ronnykg/Iontoforese/Read.Write/Resources/Carol1.jpg

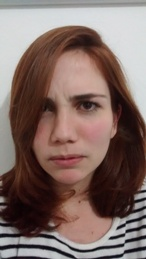
Read.Write/Resources/Carol1.jpg
