ronnykg/Iontoforese/Dados/Ana Carolina Maia Santos/Maos.png

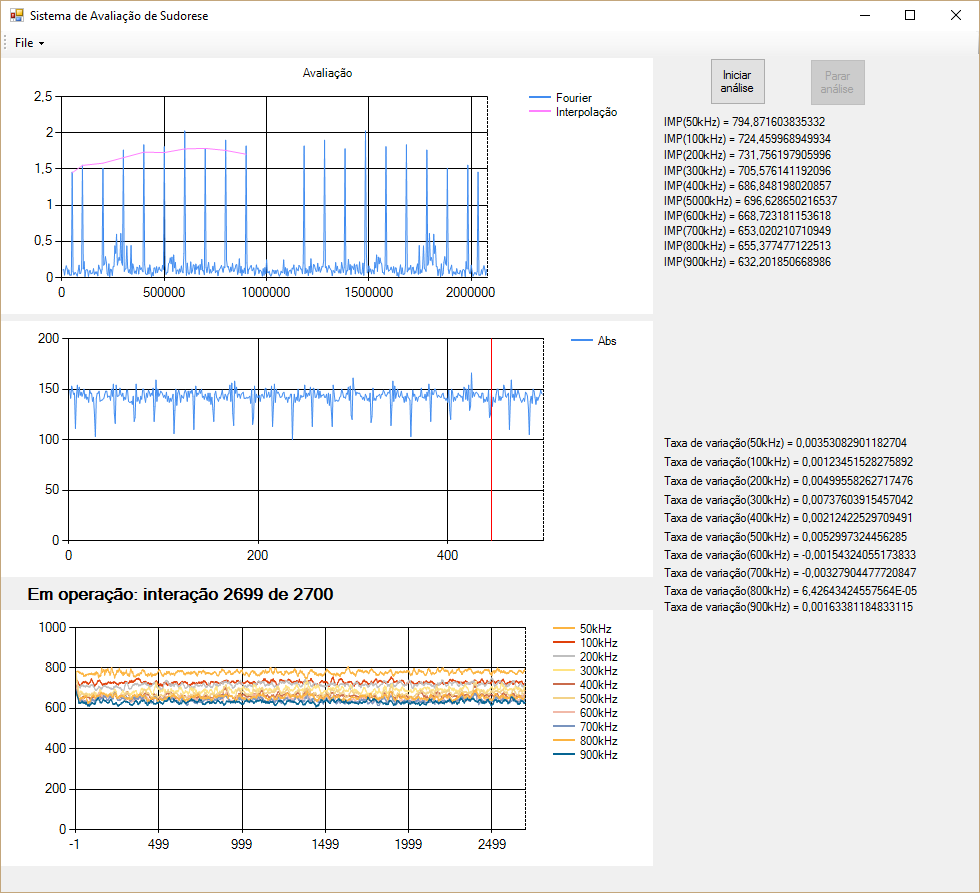
Dados/Ana Carolina Maia Santos/Maos.png
