ronnykg/Iontoforese/Dados/Ana Carolina Maia Santos/Pes.png

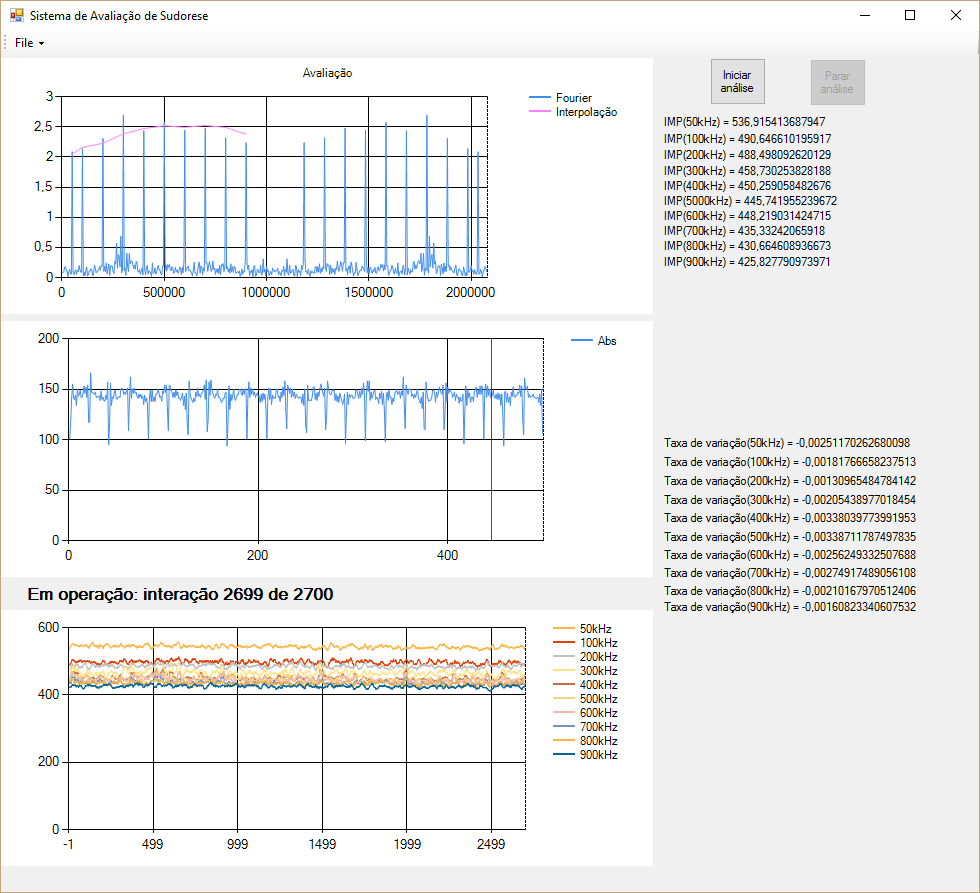
Dados/Ana Carolina Maia Santos/Pes.png
