ronnykg/Iontoforese/Dados/Bruno antonio bugardt/mao.png

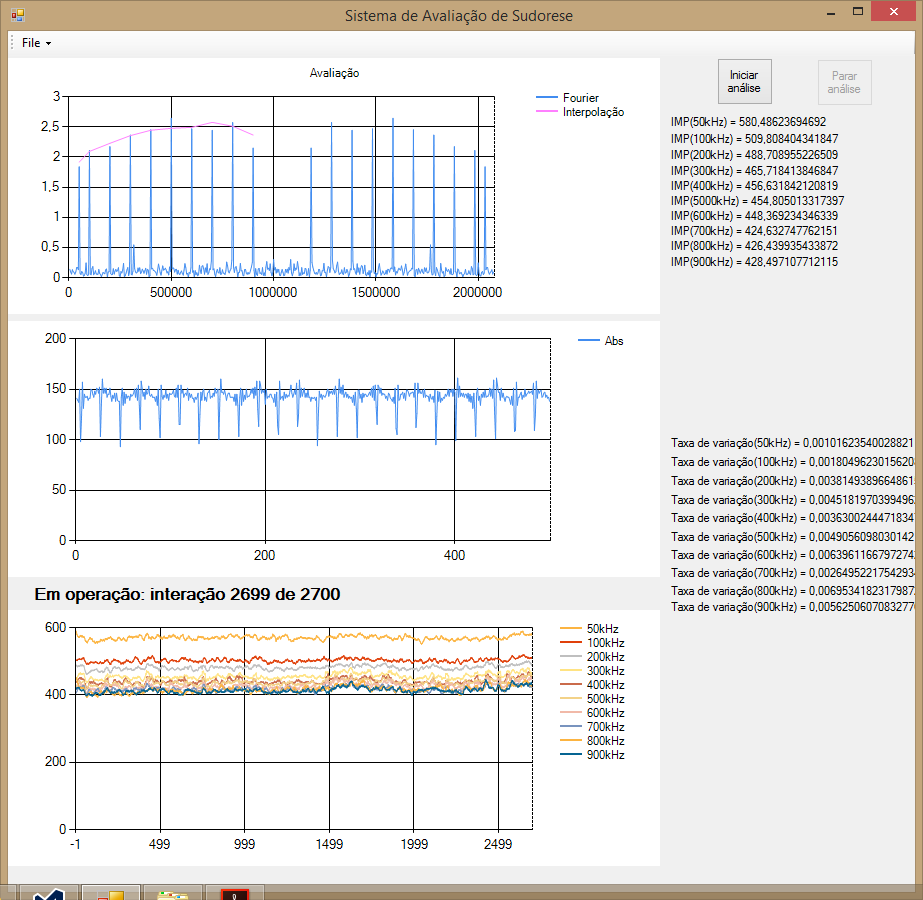
Dados/Bruno antonio bugardt/mao.png
