ronnykg/Iontoforese/Dados/Bruno Pires/maos.png

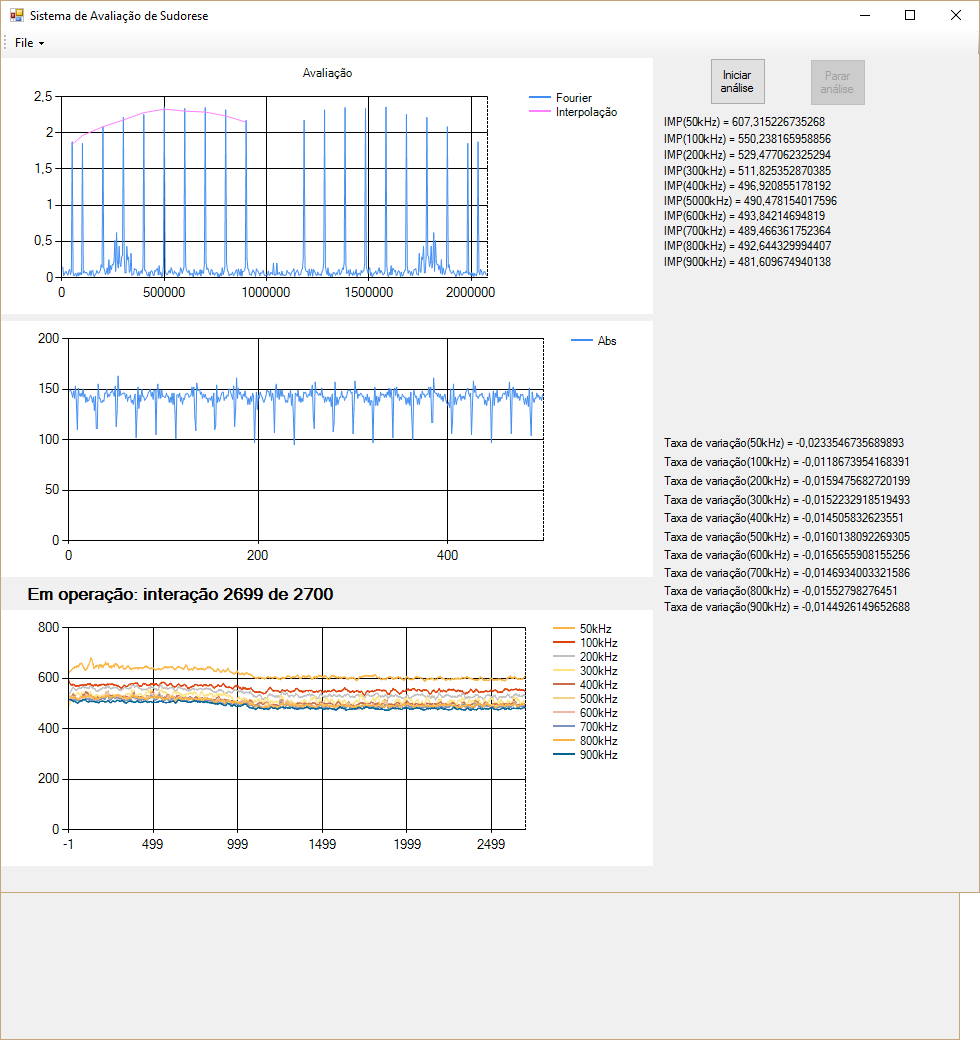
Dados/Bruno Pires/maos.png
