ronnykg/Iontoforese/Dados/Diego Coscodai/maos.png

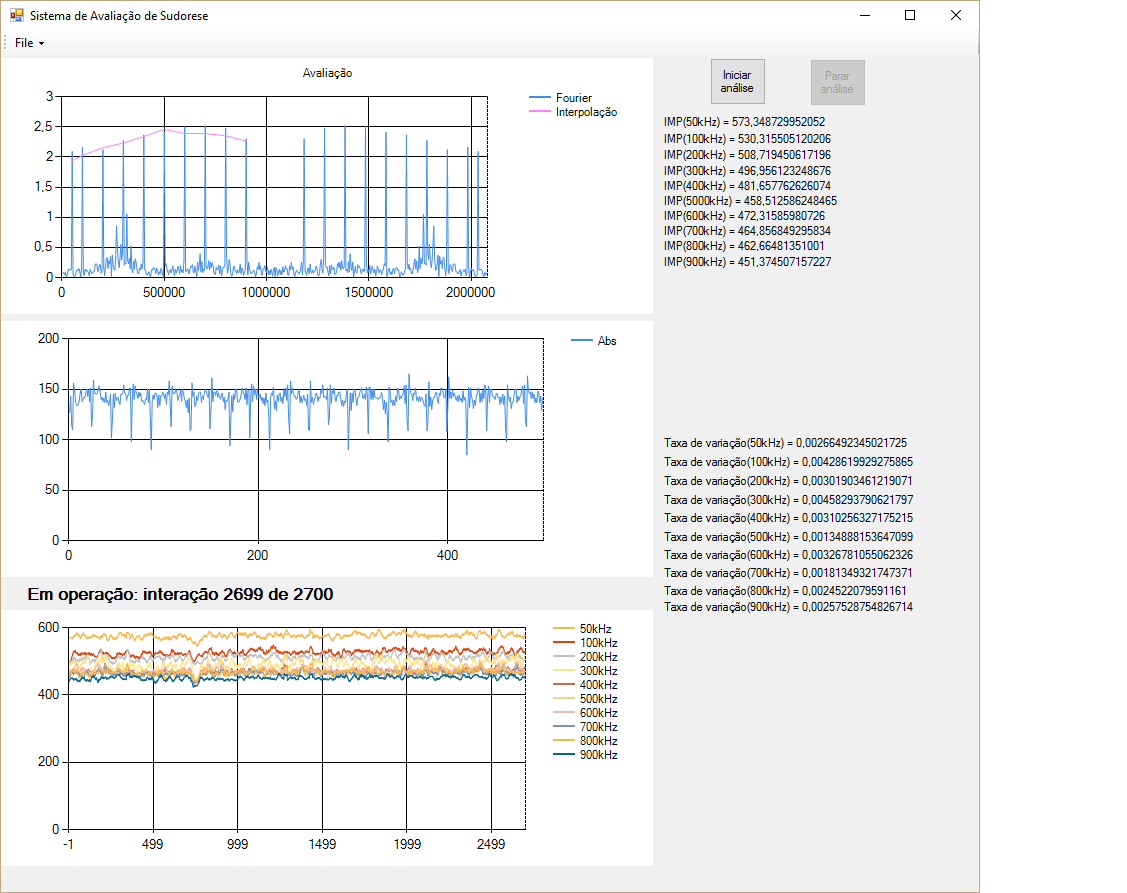
Dados/Diego Coscodai/maos.png
