ronnykg/Iontoforese/Dados/Edu Reis Neto/maos.png

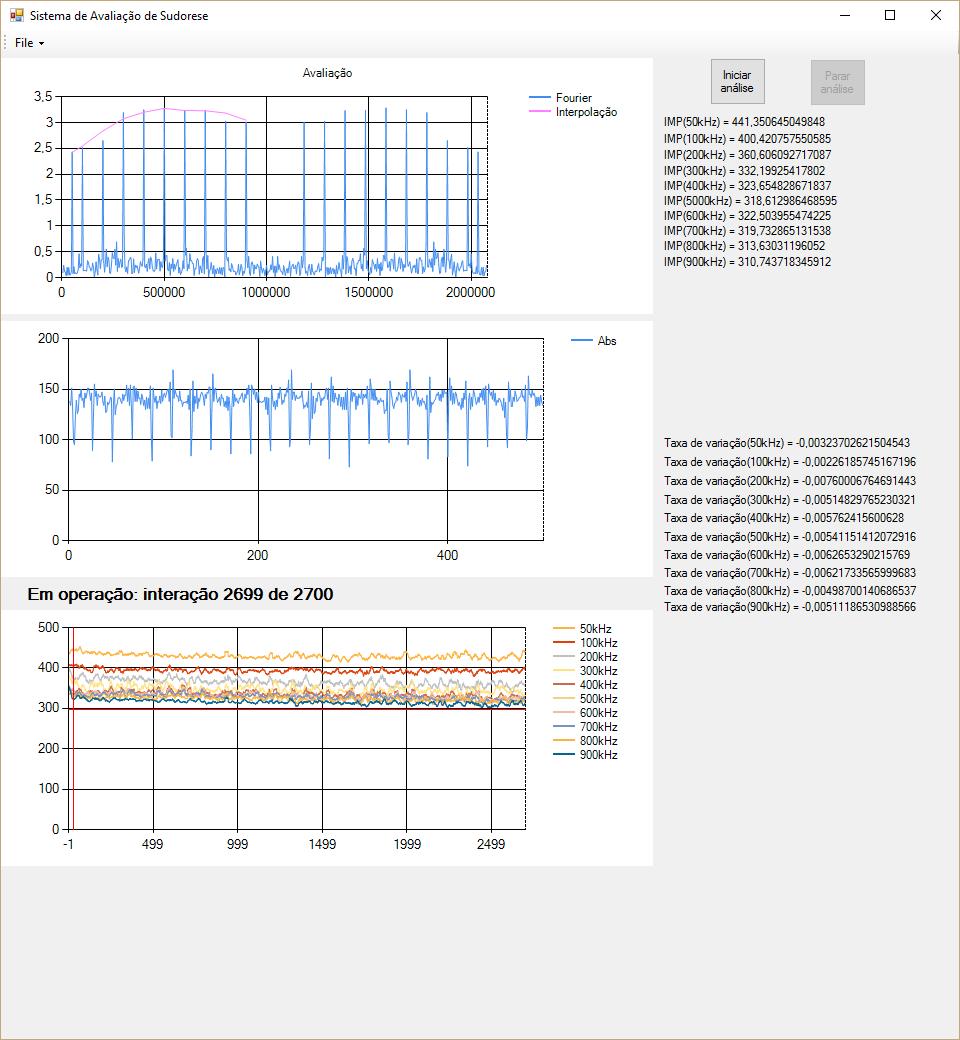
Dados/Edu Reis Neto/maos.png
