ronnykg/Iontoforese/Dados/Eronir Sislarte/Pes.png

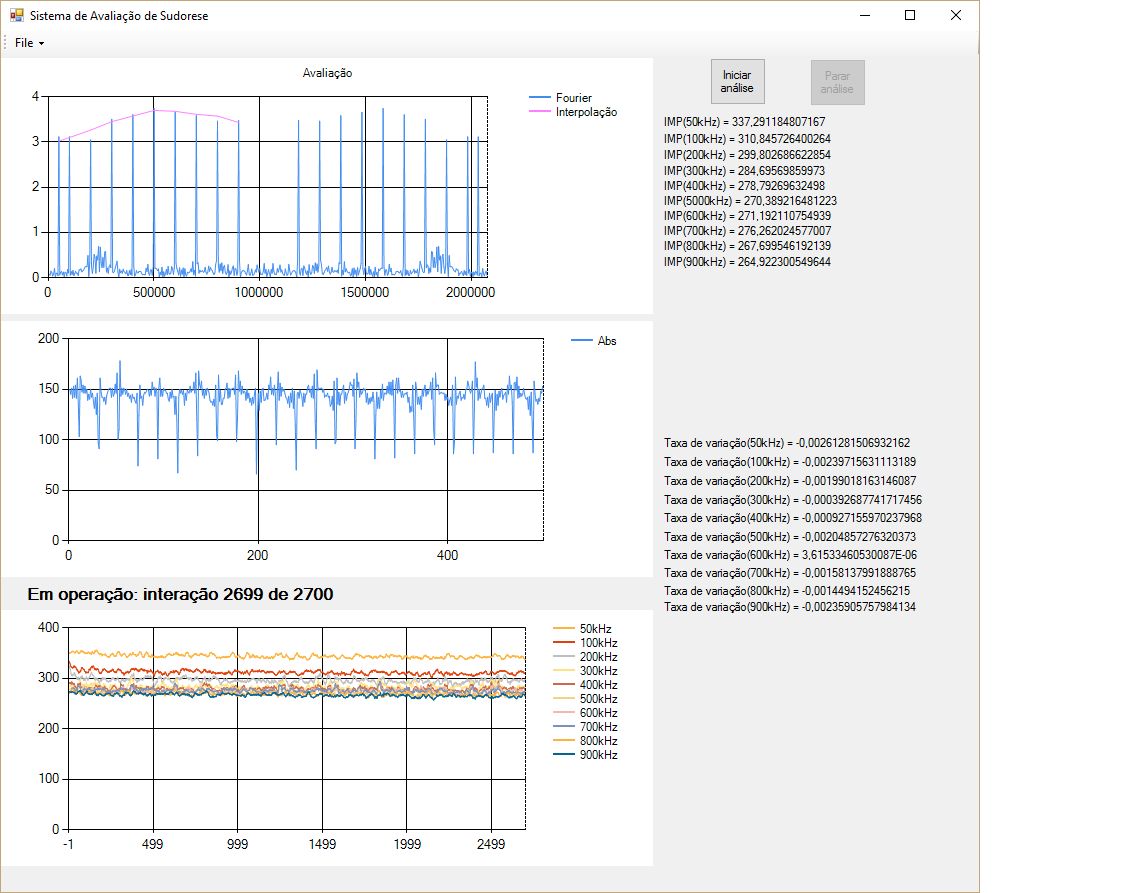
Dados/Eronir Sislarte/Pes.png
