ronnykg/Iontoforese/Dados/Ledi Isidoro/maos.png

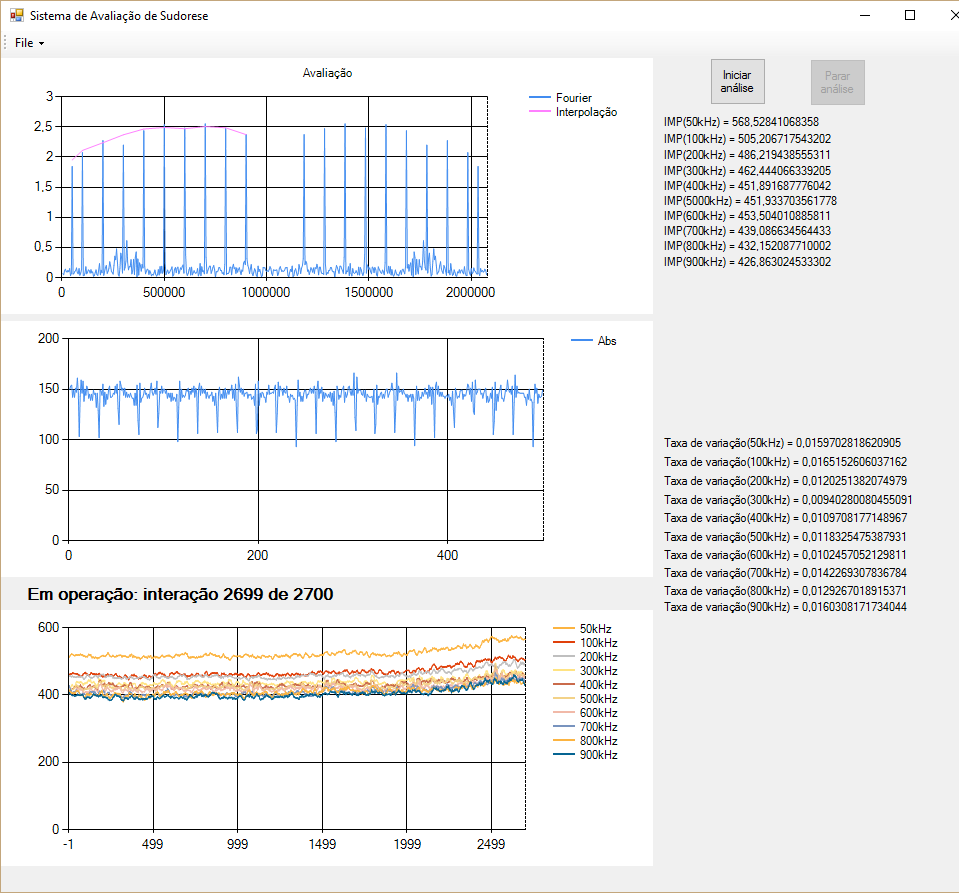
Dados/Ledi Isidoro/maos.png
