ronnykg/Iontoforese/Dados/Lorival de Oliveira/maos.png

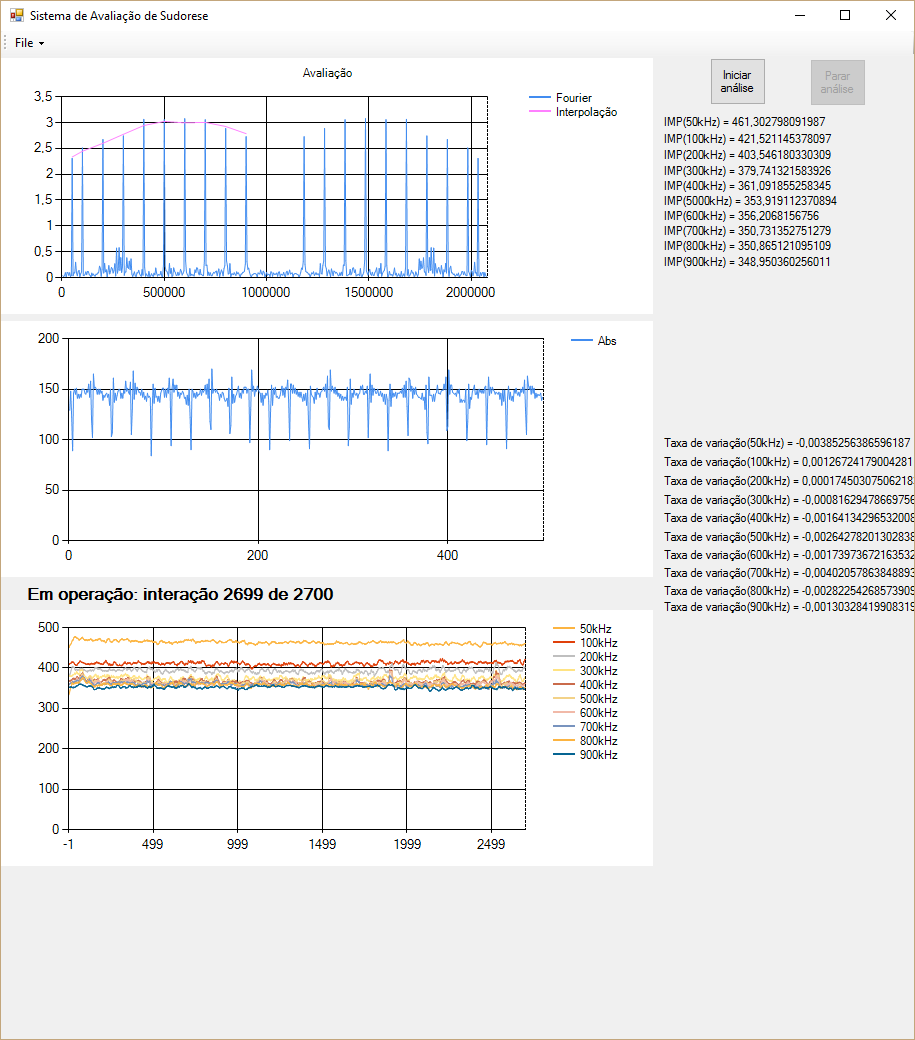
Dados/Lorival de Oliveira/maos.png
