ronnykg/Iontoforese/Dados/Lorival de Oliveira/pes.png

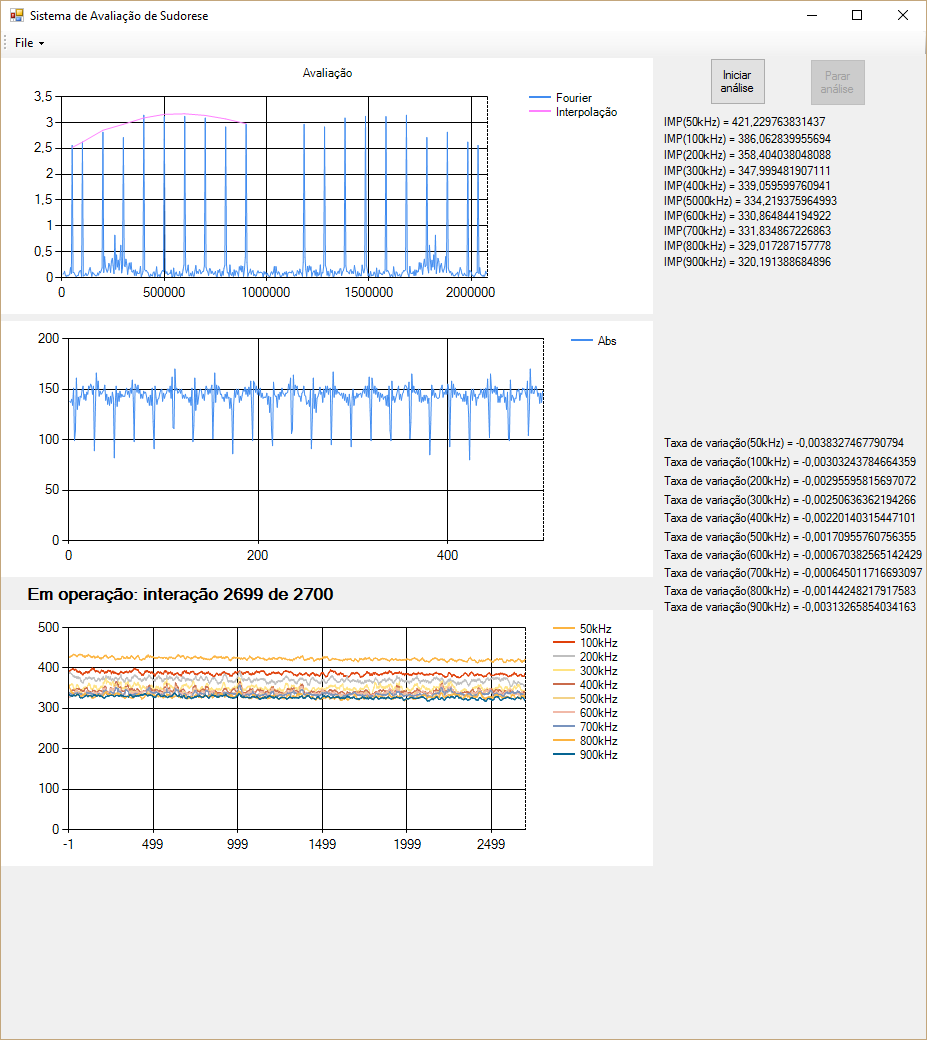
Dados/Lorival de Oliveira/pes.png
