ronnykg/Iontoforese/Dados/Lucilene Pessoa Baros/maos.png

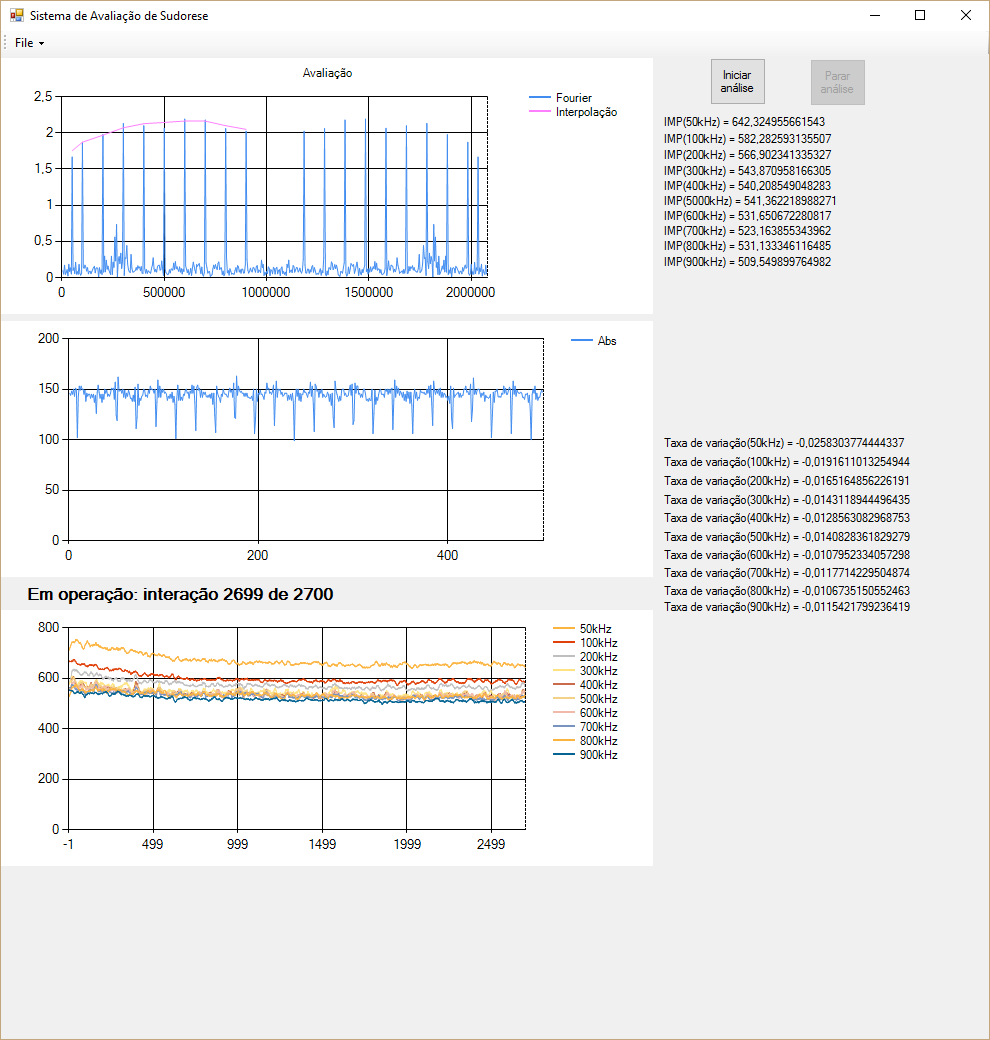
Dados/Lucilene Pessoa Baros/maos.png
