ronnykg/Iontoforese/Dados/Maria Geralda Dias/pes.png

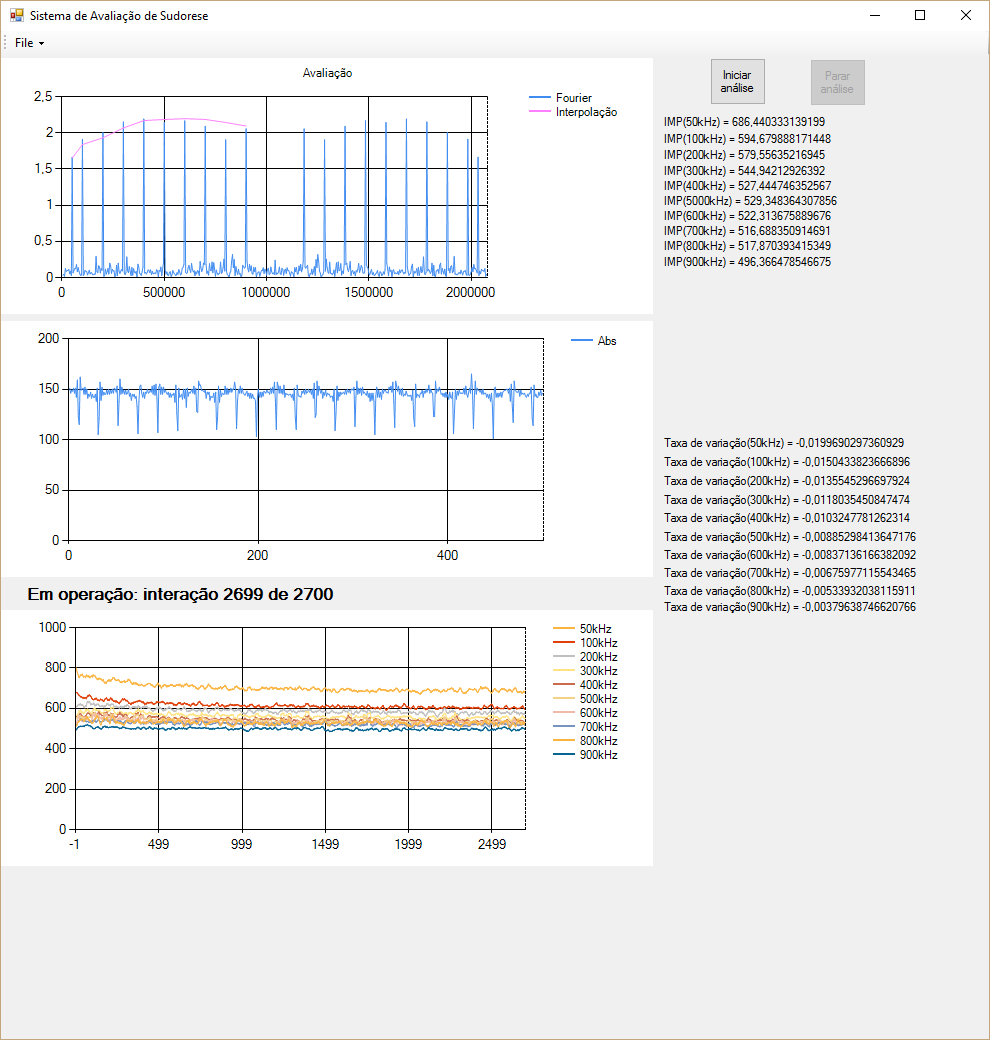
Dados/Maria Geralda Dias/pes.png
