ronnykg/Iontoforese/Dados/Miguel Soria Negreiros/pes.png

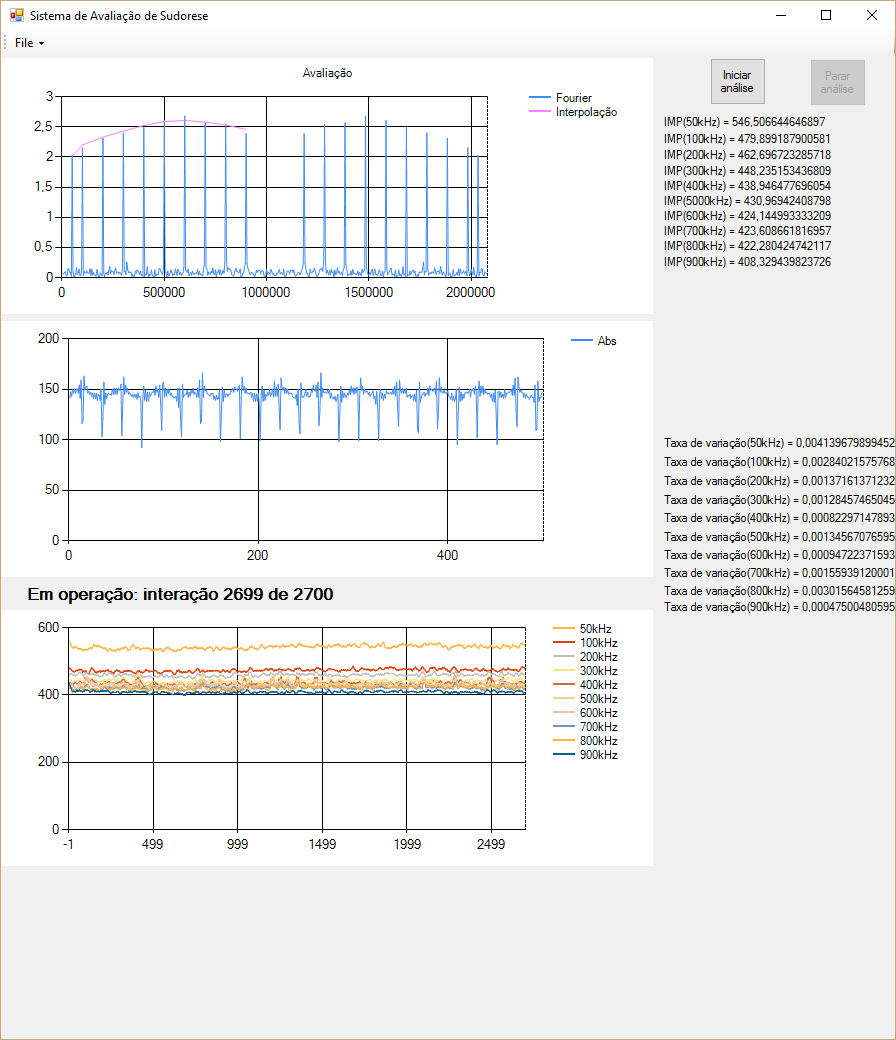
Dados/Miguel Soria Negreiros/pes.png
