ronnykg/Iontoforese/Dados/Zteste Piloto/Coscomal/mae.png

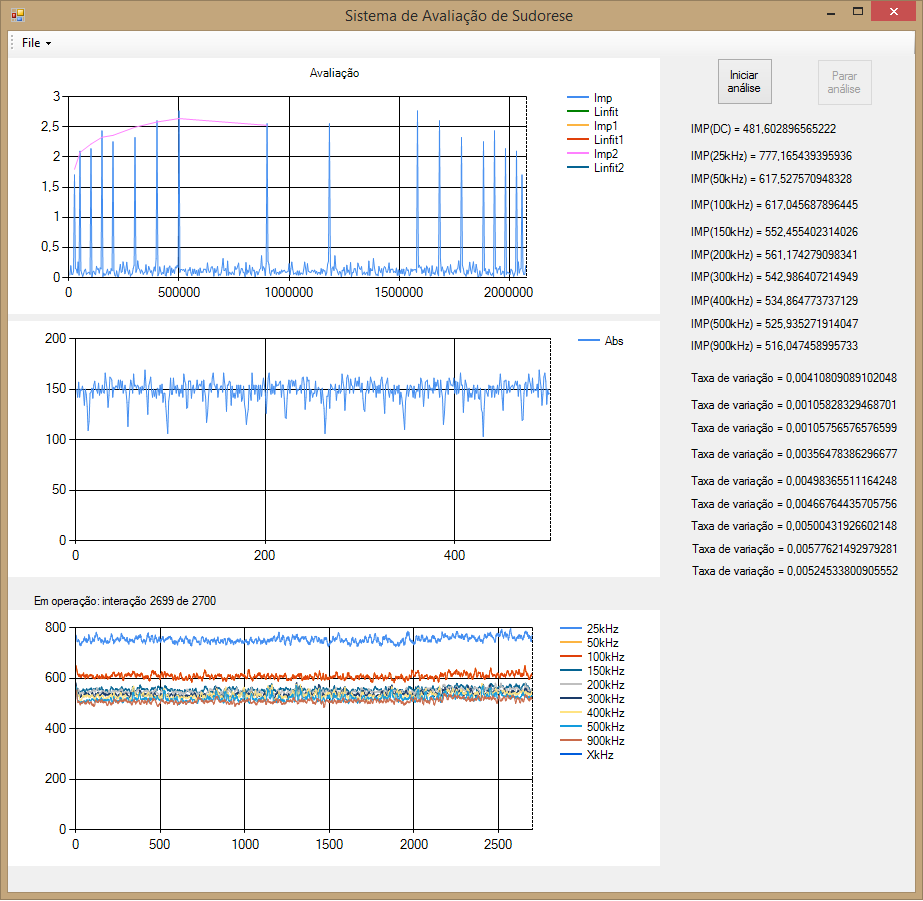
Dados/Zteste Piloto/Coscomal/mae.png
