ronnykg/Iontoforese/Read.Write/Resources/phys1_3f_3.png

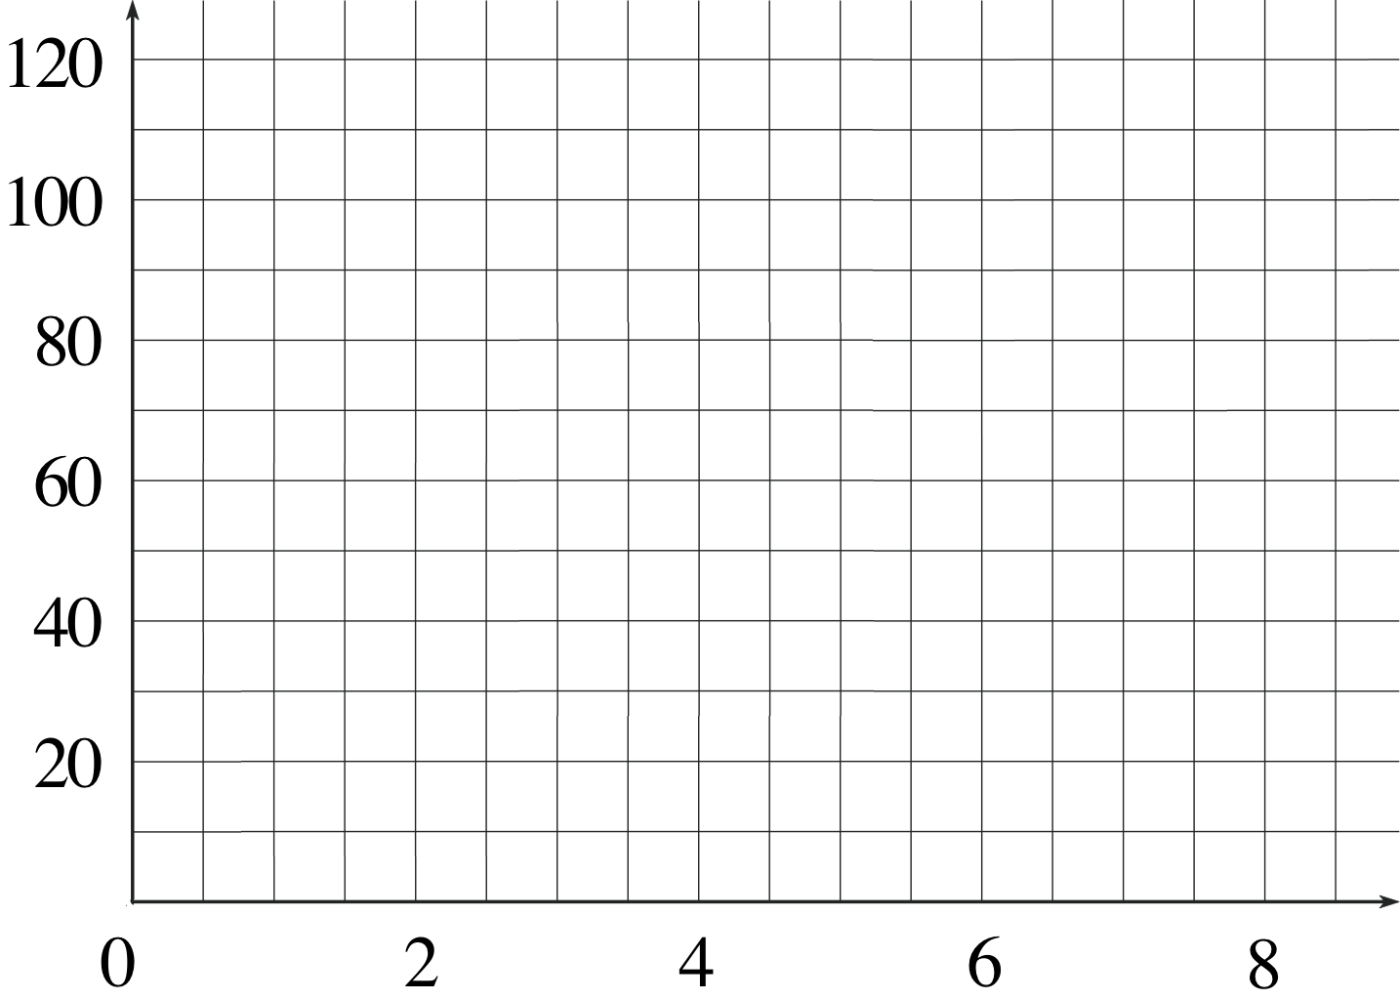
Read.Write/Resources/phys1_3f_3.png
