ronnykg/Iontoforese/NOTCH.xlsx

Sheet: Plan1
C= | 5e-07 | 0,47+0,022 | OK
R= | 5305.16477 | 3+1,2+1,1 | OK | R3 = | 2652.582385 | 1,5+1,2 | OK | Quantidade | Resistores
Q= | 2.75 |  |  | C3= | 1e-06 |  | OK | 1 | 3k
Ra= | 10000 |  | OK |  |  |  |  | 2 | 1,2k | Etapas | Fev | Mar | Abr | Mai | Jun | Jul | Ago | Set | Out | Nov | Dez | Jan | Fev | Mar
Rb= | 100000 |  | OK |  |  |  |  | 1 | 1,1k | Revisão e atualização bibliográfica sobre o contexto do projeto
 |  |  |  |  |  |  |  | 1 | 100k | Montagem de protótipo para validação do conceito
 |  |  |  |  |  |  |  | 3 | 10k | Testes Preliminares
 |  |  |  |  |  |  |  | 1 | 2.21 | Integração com FPGA
 |  |  |  |  |  |  |  | 1 | 0 (jumper) | Criação da interface IHM
 | G = 5 + 200k/RG |  |  |  |  |  |  | 1 | 1,5k | Confecção da placa de conversão de sinais
 | G = | 25 |  |  |  |  |  | Quantidade | Capacitores | Soldagem da placa
1 | Rg = | 10000 |  |  |  |  |  | 1 | 0,47u | Validação do equipamento
1 | lm358 |  |  |  |  |  |  | 1 | 0,022u | Comitê de ética
2 | ina122 |  |  |  |  |  |  | 1 | 1u | Testes com pacientes
 |  |  |  |  |  |  |  | Quantidade | Cis | Escrita da dissertação
 |  |  |  |  |  |  |  | 3 | Ina122 | Publicações
 |  |  |  |  |  |  |  | 1 | Lm358

Sheet: Plan2
 | Tensão | Resistência
Ricardo | 0.91 | 5008.928571 | G= | 25
Jeff | 0.32 | 14244.14062
Chris | 1.1 | 4143.75
Jorge | 0.3 | 15193.75
Diogo | 1.1 | 4143.75
Lucas | 0.095 | 47980.26316
Fernando | 1.28 | 3561.035156
Ronny | 0.625 | 7293
Ronny | 0.48 | 9496.09375
José | 1.22 | 3736.168033
José | 2.18 | 2090.883028
Thayse | 0.51 | 8937.5
Bruno | 0.49 | 9302.295918
Lucenara | 0.21 | 21705.35714
Lucenara | 0.23 | 19817.93478
Yukari | 0.2 | 22790.625
Diego | 0.7 | 6511.607143
Will | 0.32 | 14244.14062

Sheet: Plan3
Jan | Fev | Mar | Abr | Mai | Jun | Jul | Ago | Set | Out | Nov | Dez |  | Revisão Bibliográfica |  | Dispositivo |  | PROCESSAMENTO
 | 9 CE | 9 Reunião CÉ | 13 CE |  |  |  |  |  |  |  |  | # | Diabetes Miellitus | # | Confirmar layout | # | Teste ALTERA
 | 23 CE | 23 CE | 27 CE |  |  |  |  |  |  |  |  | # | Neuropatias multiplas |  | Característica de erro |  | Aquisição e analise
 |  |  |  |  |  |  |  |  |  |  |  | # | Neuropatias expecíficas | # | AD Converter ad9288 |  | Injeção multi-frequencial
 |  |  |  |  |  |  |  |  |  |  |  | # | Glândulas (incluindo saliva) | # | DA Converter ad5445 |  | Recepção
 |  |  |  |  |  |  |  |  |  |  |  | # | Fisiologia (Neuropatias) | # | Minimalista? | # | PC comunication?
 |  |  |  |  |  |  |  |  |  |  |  | # | Instrumentação (tipo de tratamento do sinal) |  | Auto alimentado | # | Disponibilização de dados
 |  |  |  |  |  |  |  |  |  |  |  | # | Processamento do sinal | # | Placas inox
 |  |  |  |  |  |  |  |  |  |  |  | # | Tipo de Hardware (justificativa) |  | Estrutural 3D - projeto?
 |  |  |  |  |  |  |  |  |  |  |  |  | OBJETIVO
 |  |  | Soldar AD | Testar |  |  |  |  |  |  |  |  | TER UM EQUIPAMENTO QUE POSSA MEDIR COM CONFIABILIDADE PROBLEMAS DE
 |  |  | Soldar DA | Testar |  |  |  |  |  |  |  |  | CONDUÇÂO NERVAL RELACIONADOS A NEUROPATIA PERIFÉRICA, TESTÁ-LO EM
 |  |  | Soldar resto | Testar |  |  |  |  |  |  |  |  | PESSOAS COM DIABETES, NEUROPATIA E SEM SIMTOMAS PARA COROBORAR COM
 |  |  | Injetar sinal multifrequencial |  |  |  |  |  |  |  |  |  | A QUALIDADE DO EQUIPAMENTO.
 |  |  | Receber sinal e fazer fourier
 |  |  | Melhor interface C# |  |  |  |  |  |  |  |  |  | UTILIZAR TATICAS DE PROCESSAMENTO DE SINAIS PARA EXTRAIR MAIS DADOS DOS
 |  |  | Embarcar |  |  |  |  |  |  |  |  |  | QUE OS ATUALMENTE ENCONTRADOS NA LITERATURA.
 |  |  | Apresentação

Sheet: Lista de materiais
 |  |  | 2k | 3.74k | 4.99k |  | 12.7k | 20k | 24k | 30k |  |  |  | 2.2
 | 1.5k | 3.3k | 4.7k | 5.6k | 6.8k | 10k |  | 12k | 22k | 27k | PoT 100k | 4.7uf | 100nf | 1pf | 10pf | LT6323 | AD9288 | AD5445 | Barra pino(20x2) | Born alimentação | Jumper | Barra pino (3x1)
Ponte de Wheatstone |  |  |  |  |  | 9
Filtro 3Mhz | 2 | 2 |  |  |  |  |  |  |  |  | 1 | 4 | 4 |  | 4 | 1
Controle automático de ganho |  |  | 3 | 3 | 3 | 3 | 3 | 3 | 3 | 21 |  |  |  |  |  | 3
ADC |  |  |  |  |  |  |  |  |  |  |  |  |  |  |  |  | 2
DAC |  |  |  |  |  |  |  |  |  |  |  |  |  | 1 |  |  |  | 1
Avulsos |  |  |  |  |  |  |  |  |  |  |  |  |  |  |  |  |  |  | 2 | 6 | 3 | 3
 | 4 | 6 | 6 | 9 | 7 | 25 | 6 | 6 | 6 | 45 |  | 8 | 8 | 2 | 8
 |  |  |  |  |  |  |  |  |  |  |  |  |  |  |  |  |  |  |  |  | x'
 | 1.5k | 1.2k | 2k | 3.3k | 4.7k | 5.6k | 10k | 12k | 15k | 30k
Controle automático de ganho | 10 | 10 | 10 | 10 | 10 | 10 | 25 | 10 | 10 | 10 |  | 3 | 10 |  | 10 | 4 | 2 | 1
SOLDAR PLACA ALIMENTAÇÂO | AMPOPS |  |  | POT? |  | BORNs? |  |  | BATERIA 9V?
SOLDAR DAC - TESTAR
SOLDAR FILTRO, GANHO - TESTAR | TROCAR COMPONENTES COM PLACA ANT.
SOLDAR CONT de GANHO - TESTAR | GANHOS VARIADOS. |  |  |  |  | R = 1,2k 5,6k 15k
SOLDAR ADC - TESTAR

Sheet: Pacientes
NOME | Sexo | Idade | Peso | Altura | IMC | Diabetes | Duração diabetes (anos) | Neuropatia aut. | HbA1C (%) | Observações(retinopatia, nefropatia..) | Contato | 1a | 1b | 2a | 2b | 3a | 3b | 4a | 4b | 5a | 5b | 6a | 6b
Ricardo | M | 26 | 75 | 1.8 | 23.14814815 | n | n | n | n | n
Andreza Souza | F | 40 | 77 | 1.64 | 28.62879239 | 1 | 27 | n | 8.4 | Sintrome turne carter, nervo do pulso LER
Bruno antonio bugardt | M | 23 | 63 | 1.7 | 21.79930796 | n | n | n | n | n
Deise Luciano | F | 43 | 94 | 1.7 | 32.52595156 | 2 | 20 | n | 8.9 | n
Bruno Lima | M | 25 | 80 | 1.8 | 24.69135802 | n | n | n | n | n
Guilherme Nascimento | m | 18 | 60 | 1.7 | 20.76124567 | 1 | 15 | n | 8.5 | n
Denise Cristina Costa Custodio | F | 29 | 78 | 1.45 | 37.09869203 | 2 | 6 | n | 7 | n
Diego Coscodai | M | 28 | 77 | 1.78 | 24.30248706 | 1 | 10 | n | 6.5 | n |  | 0 | 0 | 0 | 0 | 0 | 0 | 0 | 0 | 0 | 0 | 0 | 0
Vanessa Steffens | F | 21 | 65 | 1.55 | 27.05515088 | 1 | 19 | possível | 10.3 | edema nos Membros inferiores, dores, caimbras e glicemia alta
Rosimere Laus | F | 50 | 60 | 1.53 | 25.6311675 | 1 | 8 | possível | 10.4 | Calos, caibrã.
Jessica Thamara Fernandes | F | 24 | 60 | 1.58 | 24.03460984 | 1 | 12 | n | 6.6 | Gravida
Nilse | F | 46 | 54 | 1.57 | 21.90758246 | 1 | 34 | S | 7.8 | Retinopatia, amputação de dedo mínimo | 32425000 | 0 | 0 | 0 | 0 | 0 | 0 | 3 | 3 | 0 | 0 | 3 | 3
Anderson da Rosa | M | 36 | 70 | 1.68 | 24.8015873 | 1 | 33 | S | 7.1 | Refluxo, problema nos rins, retinopatia. Sem indícios de neuro periférica.Cloridrano de betaina (controle de pH esfago) | 91820330/36655125 | 0 | 0 | 0 | 0 | 1 | 1 | 2 | 2 | 0 | 0 | 0 | 0
Mateus Fafretto | M | 24 | 83 | 1.78 | 26.19618735 | n | n | n | n | n | 5491313862 | 0 | 0 | 0 | 0 | 0 | 0 | 0 | 0 | 0 | 0 | 0 | 0
Joao Antonio Marcola | M | 24 | 86 | 1.78 | 27.1430375 | n | n | n | n | n |  | 0 | 0 | 0 | 0 | 0 | 0 | 0 | 0 | 0 | 0 | 0 | 0
Jose Berkenbrock | M | 27 | 90 | 1.83 | 26.8744961 | n | n | n | n | n | 96039991 | 0 | 0 | 0 | 0 | 0 | 0 | 0 | 0 | 1 | 1 | 0 | 0
Miguel Soria Negreiros | M | 32 | 74 | 1.7 | 25.60553633 | n | n | n | n | n | 92 991467294 | 0 | 0 | 0 | 0 | 0 | 0 | 0 | 0 | 0 | 0 | 0 | 0
Edu Reis Neto | M | 22 | 92 | 1.9 | 25.48476454 | 1 | 19 | n | 9 | n | 96686037 | 0 | 0 | 0 | 0 | 0 | 0 | 0 | 0 | 0 | 0 | 0 | 0
Maria Geralda Dias | F | 47 | 69 | 1.58 | 27.63980131 | 2 | 8 | n | 8 | n | 96034202 | 0 | 0 | 0 | 0 | 2 | 1 | 0 | 0 | 0 | 0 | 0 | 0
Lucilene Pessoa Baros | F | 49 | 64 | 1.53 | 27.339912 | 1 | 10 | S | 12 | Homeprazol/ Refluxo | 84784471 | 1 | 1 | 3 | 3 | 1 | 1 | 3 | 3 | 0 | 0 | 3 | 3
Jean Pereira da Rocha | M | 24 | 56 | 1.75 | 18.28571429 | n | n | n | n | n | 91796340 | 0 | 0 | 0 | 0 | 0 | 0 | 0 | 0 | 0 | 0 | 0 | 0
Lorival De Oliveira | M | 38 | 71 | 1.73 | 23.72281065 | 1 | 17 | n | 6.9 | n | 98149702 | 1 | 1 | 0 | 0 | 1 | 1 | 0 | 0 | 0 | 0 | 1 | 2
Mauricio Ademir Teodoro | M | 34 | 95 | 1.89 | 26.59500014 | 1 | 26 | n | 7.2 | Dor nas pernas por canceira no fim do dia | 84705568 | 0 | 0 | 0 | 0 | 0 | 0 | 0 | 0 | ? | 1 | 0 | 0
Sonir Schafer | M | 49 | 84 | 1.72 | 28.39372634 | 1 | 1.5 | n | 7.64 | Cansaço, Ligação do reto | 84646548 | 0 | 0 | 0 | 0 | 0 | 0 | 0 | 0 | 0 | 0 | 0 | 0
Jorge Loureiro | M | 51 | 77 | 1.81 | 23.50355606 | n | n | n | n | n | 98148778 | 0 | 0 | 0 | 0 | 0 | 0 | 0 | 0 | 0 | 0 | 0 | 0
Bruno Pires | M | 25 | 84 | 1.89 | 23.51557907 | n | n | n | n | n | 91691319 | 0 | 0 | 0 | 0 | 0 | 0 | 0 | 0 | 0 | 0 | 1 | 0
Ledi Isidoro | F | 54 | 100.5 | 1.54 | 42.37645471 | 2 | 4 | possível | n | Perda de suavidade nos pés mesmo com uso de cremes | 99421688 | 0 | 0 | 0 | 0 | 0 | 0 | 0 | 0 | 0 | 0 | 3 | 3
Maikon Simas | M | 36 | 107 | 1.63 | 40.27249802 | 2 | 9 | n | 7 | Pseuriase tratada, deficiencia vit. D | 84523792 | 1 | 1 | 0 | 0 | 0 | 0 | 0 | 0 | 0 | 0 | 0 | 0
Maria Luiza Vida Lens | F | 45 | 72 | 1.45 | 34.24494649 | 2 | 3 | n | 7 | Artrose, derrame no braço direito, reumatismo cranico | 96698653 | 0 | 0 | 3 | 2 | 0 | 0 | 1 | 1 | 1 | 3 | 1 | 2
Eronir Sislarte | M | 55 | 102 | 1.82 | 30.79338244 | 1 | 1 | n | 8 | Transplante de figado | 96172124 | 0 | 0 | 0 | 0 | 0 | 0 | 0 | 0 | 0 | 0 | 0 | 0
Joao Batista Campos Vieira | M | 41 | 67 | 1.76 | 21.62964876 | 1 | 31 | Periférica | 11.5 | Fisgadas no pé, sensação de corpo estranho no pé, neuropatia pé direito. Sensações sempre relacionadas a esforço fisico. | 84436429 | 1 | 3 | 0 | 0 | 1 | 3 | 0 | 0 | 1 | 3 | 3 | 0
Reginaldo Joaquim da Silva | M | 36 | 110 | 1.69 | 38.51405763 | 1 | 19 | n | 7.2 | Def. de vitamina D. Insuficiencia Renal (45%) . Inchaço no periodo noturno nos pés causado por problemas renais. | 32654584/99594475 | 0 | 0 | 0 | 0 | 0 | 0 | 0 | 0 | 0 | 0 | 0 | 0
Sandro Vieira de Souza | M | 47 | 71 | 1.72 | 23.99945917 | 1 | 36 | n | 6.4 | Sente dor no nervo unar, tendões, ombros. Dormencia gerada pela dor no nervo | 49 32784454/49 99632608 | 0 | 0 | 0 | 0 | 0 | 0 | 1 | 0 | 0 | 0 | 0 | 0
Ivania Vieira de Souza | F | 47 | 79 | 1.64 | 29.37239738 | 1 | 24 | Periférica | 9 | Def. vit D. Toma Neurapentina e Duoxetina (para dor da neuropatia). 10 anos de neuropatia. Calor em excesso no verão nos pés. Dormencia em regiões dos pes, doi ao calçar. Dor na região dos gluteos. Pés inchados | 33550559 99014368 | 1 | 2 | 1 | 1 | 1 | 0 | 3 | 0 | 1 | 1 | 1 | 2
Lucas Herzer | M | 24 | 65 | 1.71 | 22.22906193 | n | n | n | n | n |  | 0 | 0 | 0 | 0 | 0 | 0 | 0 | 0 | 0 | 0 | 0 | 0
Sariane Ribeiro Silva | F | 21 | 58 | 1.6 | 22.65625 | n | n | n | n | Possível Anemia |  | 0 | 0 | 0 | 0 | 1 | 1 | 1 | 1 | 0 | 0 | 0 | 0
Jefson De Souza Junior | M | 26 | 90 | 1.71 | 30.77870114 | n | n | n | n |  |  | 0 | 0 | 0 | 0 | 0 | 0 | 0 | 0 | 0 | 0 | 0 | 0
Anna Carolina Russi | F | 25 | 49 | 1.6 | 19.140625 | n | n | n | n | n |  | 0 | 0 | 0 | 0 | 0 | 0 | 0 | 0 | 0 | 0 | 0 | 0
Thiago Albuquerque Baratto | M | 26 | 70 | 1.7 | 24.22145329 | n | n | n | n | Alcolismo, alergia a algo (prov. Cachorro). |  | 0 | 0 | 0 | 0 | 0 | 0 | 0 | 0 | 0 | 0 | 1 | 1
Ana Carolina Maia Santos | F | 24 | 63 | 1.73 | 21.0498179 | n | n | n | n | Anemia |  | 0 | 0 | 0 | 0 | 1 | 2 | 1 | 1 | 0 | 0 | 1 | 1
Vagner Rodrigues | M | 26 | 65.8 | 1.65 | 24.16896235 | n | n | n | n | n |  | 0 | 0 | 0 | 0 | 0 | 0 | 0 | 0 | 0 | 0 | 0 | 0
 |  |  |  |  | #DIV/0!
 |  |  |  |  | #DIV/0!
 |  |  |  |  | #DIV/0!
 |  |  |  |  | #DIV/0!
 |  |  |  |  | #DIV/0!
 |  |  |  |  | #DIV/0!
 |  |  |  |  | #DIV/0!
 |  |  |  |  | #DIV/0!
 |  |  |  |  | #DIV/0!
 |  |  |  |  | #DIV/0!
 |  |  |  |  | #DIV/0!
 |  |  |  |  | #DIV/0!
 |  |  |  |  | #DIV/0!
 |  |  |  |  | #DIV/0!
 |  |  |  |  | #DIV/0!
 |  |  |  |  | #DIV/0!
 |  |  |  |  | #DIV/0!

Sheet: Descartados
Julia Wolff | F | 35 | 59 | 1.61 | 22.76146754 | n | n | n | n | Possível Deficiencia de vit. D | 4784912282 | 0 | 0 | 0 | 0 | 0 | 0 | 0 | 0 | 0 | 0 | 3 | 1
Cristina Schreiber | F |  |  |  | #DIV/0! | n | n | n | n | 8 pinos de titânio na perna
