ronnykg/Iontoforese/(list of files, cad)

Other CAD files:
VHDL/simulation/modelsim/ieee_proposed/fixed_float_types/_vhdl.psm
VHDL/simulation/modelsim/ieee_proposed/fixed_pkg/_vhdl.psm
VHDL/simulation/modelsim/ieee_proposed/fixed_pkg/body.psm
VHDL/simulation/modelsim/ieee_proposed/float_pkg/_vhdl.psm
VHDL/simulation/modelsim/ieee_proposed/float_pkg/body.psm
VHDL/simulation/modelsim/rtl_work/de2_clock/a.psm
VHDL/simulation/modelsim/rtl_work/devreq/handler.psm
VHDL/simulation/modelsim/rtl_work/devreq_inc/_vhdl.psm
VHDL/simulation/modelsim/rtl_work/drv/handler.psm
VHDL/simulation/modelsim/rtl_work/hal/handler.psm
VHDL/simulation/modelsim/rtl_work/isp_drv/_vhdl.psm
VHDL/simulation/modelsim/rtl_work/isp_hal/_vhdl.psm
VHDL/simulation/modelsim/rtl_work/isp_inc/_vhdl.psm
VHDL/simulation/modelsim/rtl_work/my_library/a.psm
VHDL/simulation/modelsim/rtl_work/types/_vhdl.psm
VHDL/simulation/modelsim/rtl_work/usb_inc/_vhdl.psm
VHDL/simulation/modelsim/rtl_work/usb_inc/body.psm
