ronnykg/Iontoforese/Dados/Zteste Piloto/guilherme/Resultado.txt

884,831226188367 750,685134251003 750,108544539587 632,343335956917 658,969294934877 632,224453397394 599,501538025164 583,694009222684 579,266520409503
892,104361916262 746,166161080883 745,592785432888 635,372041945918 659,020221451846 630,906515384897 601,920500891162 586,777852193873 582,366831613526
895,69713361933 745,643232434705 745,070228713201 634,111541589404 660,639591999668 635,291245088389 608,96287933238 593,784488098289 588,04753133418
888,475879167609 744,068555359187 743,496671607153 634,140025248989 657,366812482962 632,817264768916 613,347200428857 598,154741577932 585,899515986473
881,47015246444 736,073744562409 735,507547020046 631,876009333263 649,153986147338 625,745525055097 609,734484447237 596,010940045821 581,407902584925
866,805808796968 726,580056486925 726,020611212041 629,971963333846 640,412614106909 616,682078382403 605,943499438058 591,999188961529 576,357738861392
852,202977637368 719,072052696241 718,517947395604 627,35279469643 631,825508991398 611,438858513416 600,540633559621 588,954010499008 570,700882018434
838,250514041457 706,661384290642 706,116105923437 622,895494761387 626,651815417924 607,761575915703 596,690967103321 582,3684148923 567,407212055633
824,938020810369 693,370055455967 692,834230380963 616,646357731271 620,192579808948 600,807549457102 591,600724126741 579,764723465699 565,095794860273
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
782,288057903264 650,522666630622 650,017316227613 583,647285413671 579,596908473812 562,92649976838 557,844449740203 548,843821500069 536,085612983959
778,723130490979 653,527055495137 653,019568257943 583,898997073108 581,862867276153 563,764648284666 558,640797659835 546,076629793086 540,458401753107
775,110164298752 654,981382925295 654,472861315817 584,633165074984 581,036701277611 564,765489533526 557,510377421601 546,803311941887 538,400802219537
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
