ronnykg/Iontoforese/adc.brd

## EAGLE design adc.brd (2016-02-25)

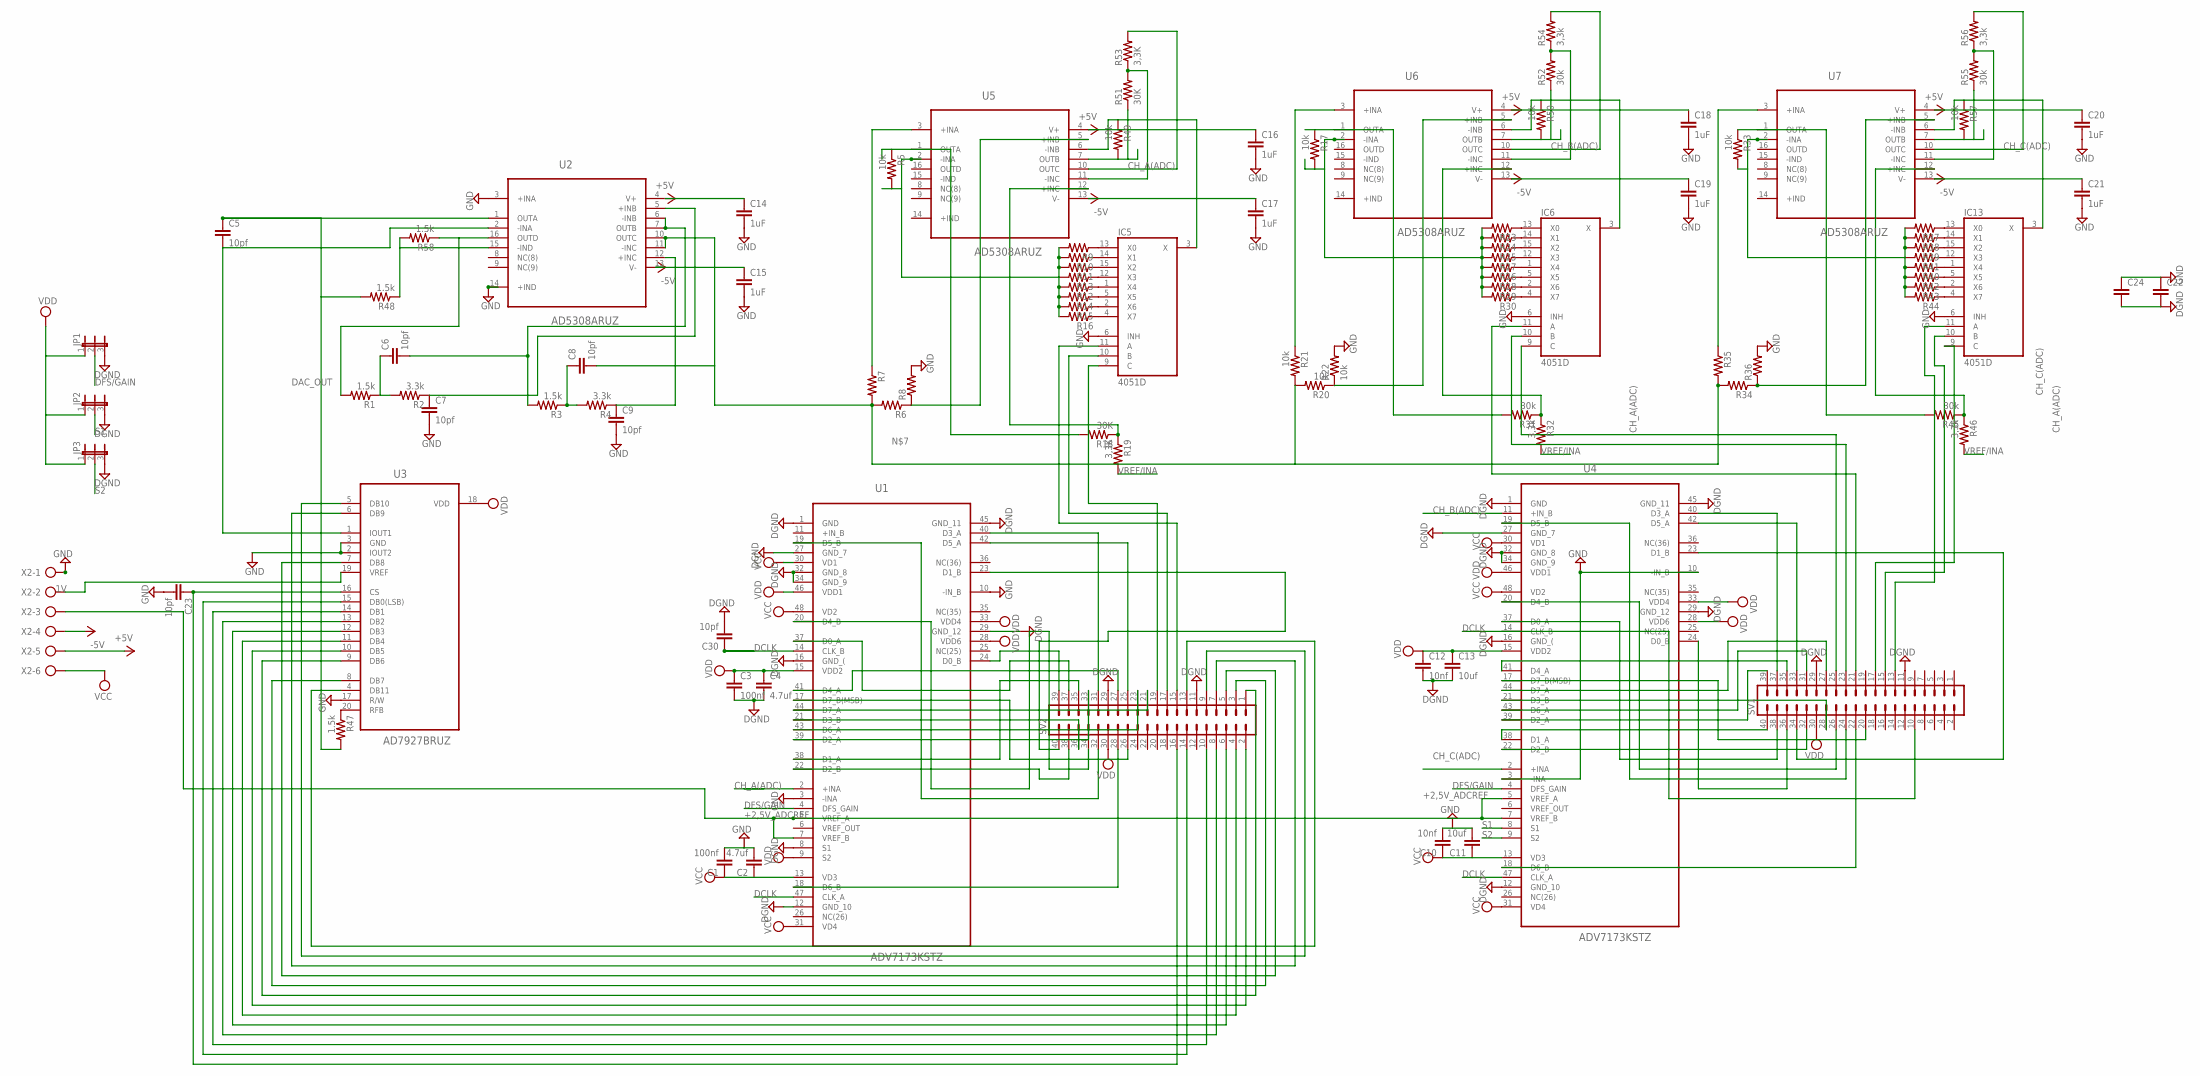
[picture p37: schematic adc.sch]

Parts:
C1, C3: 100nf; C0603
C2, C4: 4.7uf; C0603
C5, C6, C7, C8, C9, C23, C30: 10pf; C0603
C10, C12: 10nf; C0603
C11, C13: 10uf; C0603
C14, C15, C16, C17, C18, C19, C20, C21: 1uF; C0603
C22: C2,5-3; C2.5-3
C24: C10/6; C10B6
IC5, IC6, IC13: 4051D; SO16
JP1, JP2, JP3: JP2E; JP2
R1, R3, R47, R48, R58: 1.5k; 0603
R2, R4: 3.3k; 0603
R5, R17, R20, R21, R22, R33, R49, R50, R57: 10k; 0603
R6, R7, R8, R9, R10, R11, R12, R13, R14, R15, R16, R23, R24, R25, R26, R27, R28, R29, R30, R34, R35, R36, R37, R38, R39, R40, R41, R42, R43, R44: RESISTOR0603; 0603
R18, R51: 30K; 0603
R19, R53: 3,3K; 0603
R31, R45, R52, R55: 30k; 0603
R32, R46, R54, R56: 3,3k; 0603
SV1, SV2: MA20-2
U1, U4: ADV7173KSTZ; QFP50P900X900X160-48N
U2, U5, U6, U7: AD5308ARUZ; SOP65P640X120-16N
U3: AD7927BRUZ; SOP65P640X120-20N
X2: AK300/6

Connections:
1V: U3.19 (VREF), X2.2
+2,5V_ADCREF: U1.5 (VREF_A), U1.7 (VREF_B), U4.5 (VREF_A), U4.7 (VREF_B), X2.3
+5V: C14.1, C16.1, C18.1, C20.1, IC5.16 (+5V), IC6.16 (+5V), IC13.16 (+5V), U2.4 (V+), U5.4 (V+), U6.4 (V+), U7.4 (V+), X2.5
+IN_B: U1.11 (+IN_B)
-5V: C15.1, C17.1, C19.1, C21.1, IC5.7 (VEE), IC6.7 (VEE), IC13.7 (VEE), U2.13 (V-), U5.13 (V-), U6.13 (V-), U7.13 (V-), X2.4
CH_A(ADC): R53.2, U1.2 (+INA), U5.10 (OUTC)
CH_B(ADC): R54.2, U4.11 (+IN_B), U6.10 (OUTC)
CH_C(ADC): R56.2, U4.2 (+INA), U7.10 (OUTC)
DAC_OUT: C5.1, R47.2, R48.2, U2.1 (OUTA)
DCLK: C30.1, SV1.10, U1.14 (CLK_B), U1.47 (CLK_A), U4.14 (CLK_B), U4.47 (CLK_A)
DFS/GAIN: JP1.2, U1.4 (DFS_GAIN), U4.4 (DFS_GAIN)
DGND: C3.2, C4.2, C12.2, C13.2, C22.2, C24.2, C30.2, JP1.3, JP2.3, JP3.3, SV1.11, SV1.29, SV2.11, SV2.29, U1.1 (GND), U1.8 (S1), U1.12 (GND_10), U1.16 (GND_(), U1.27 (GND_7), U1.29 (GND_12), U1.32 (GND_8), U1.34 (GND_9), U1.45 (GND_11), U4.1 (GND), U4.12 (GND_10), U4.16 (GND_(), U4.27 (GND_7), U4.29 (GND_12), U4.32 (GND_8), U4.34 (GND_9), U4.45 (GND_11)
GND: C1.2, C2.2, C7.2, C9.2, C10.2, C11.2, C14.2, C15.2, C16.2, C17.2, C18.2, C19.2, C20.2, C21.2, C22.1, C23.2, C24.1, IC5.6 (INH), IC5.8 (GND), IC6.6 (INH), IC6.8 (GND), IC13.6 (INH), IC13.8 (GND), R8.2, R22.2, R36.2, U1.3 (-INA), U1.10 (-IN_B), U2.3 (+INA), U2.14 (+IND), U3.2 (IOUT2), U3.3 (GND), U3.17 (R/W), U4.3 (-INA), U4.10 (-IN_B), X2.1
unnamed: C7.1, R2.1, U2.5 (+INB)
unnamed: C6.1, R1.1, R2.2
unnamed: R48.1, R58.2, U2.15 (-IND)
unnamed: C6.2, R3.2, U2.6 (-INB), U2.7 (OUTB)
unnamed: C9.1, R4.1, U2.12 (+INC)
unnamed: C8.1, R3.1, R4.2
unnamed: C8.2, R6.2, R7.2, R20.2, R21.2, R34.2, R35.2, U2.10 (OUTC), U2.11 (-INC)
unnamed: SV2.31, U1.40 (D3_A)
unnamed: SV2.25, U1.42 (D5_A)
unnamed: SV2.39, U1.24 (D0_B)
unnamed: SV2.32, U1.19 (D5_B)
unnamed: SV2.34, U1.20 (D4_B)
unnamed: SV2.37, U1.37 (D0_A)
unnamed: SV2.27, U1.41 (D4_A)
unnamed: SV2.21, U1.44 (D7_A)
unnamed: SV2.36, U1.21 (D3_B)
unnamed: SV2.23, U1.43 (D6_A)
unnamed: SV2.33, U1.39 (D2_A)
unnamed: SV2.35, U1.38 (D1_A)
unnamed: SV2.38, U1.22 (D2_B)
unnamed: SV2.28, U1.18 (D6_B)
unnamed: SV2.26, U1.17 (D7_B(MSB))
unnamed: SV2.13, U3.4 (DB11)
unnamed: SV2.40, U1.23 (D1_B)
unnamed: SV2.9, U3.5 (DB10)
unnamed: SV2.7, U3.6 (DB9)
unnamed: SV2.5, U3.7 (DB8)
unnamed: SV2.3, U3.8 (DB7)
unnamed: SV2.1, U3.9 (DB6)
unnamed: SV2.2, U3.10 (DB5)
unnamed: SV2.4, U3.11 (DB4)
unnamed: SV2.6, U3.12 (DB3)
unnamed: SV2.8, U3.13 (DB2)
unnamed: SV2.10, U3.14 (DB1)
unnamed: SV2.14, U3.15 (DB0(LSB))
unnamed: SV1.38, U4.37 (D0_A)
unnamed: IC5.13 (X0), R9.1
unnamed: IC5.14 (X1), R10.1
unnamed: IC5.15 (X2), R11.1
unnamed: IC5.1 (X4), R12.1
unnamed: IC5.12 (X3), R13.1
unnamed: IC5.5 (X5), R14.1
unnamed: IC5.2 (X6), R15.1
unnamed: IC5.4 (X7), R16.1
unnamed: IC6.13 (X0), R23.1
unnamed: IC6.14 (X1), R24.1
unnamed: R17.2, R23.2, R24.2, R25.2, R26.2, R27.2, R28.2, R29.2, R30.2, U6.2 (-INA)
unnamed: R5.2, R9.2, R10.2, R11.2, R12.2, R13.2, R14.2, R15.2, R16.2, U5.2 (-INA)
unnamed: R18.1, R19.1, U5.12 (+INC)
unnamed: R49.2, R51.1, U5.7 (OUTB)
unnamed: IC6.15 (X2), R25.1
unnamed: IC6.1 (X4), R26.1
unnamed: IC6.12 (X3), R27.1
unnamed: IC6.5 (X5), R28.1
unnamed: IC6.2 (X6), R29.1
unnamed: IC6.4 (X7), R30.1
unnamed: R52.2, R54.1, U6.11 (-INC)
unnamed: R33.1, R45.2, U7.1 (OUTA)
unnamed: IC13.3 (X), R57.1, U7.6 (-INB)
unnamed: IC13.13 (X0), R37.1
unnamed: IC13.14 (X1), R38.1
unnamed: IC13.15 (X2), R39.1
unnamed: IC13.1 (X4), R40.1
unnamed: IC13.12 (X3), R41.1
unnamed: IC13.5 (X5), R42.1
unnamed: IC13.2 (X6), R43.1
unnamed: IC13.4 (X7), R44.1
unnamed: R34.1, R36.1, U7.5 (+INB)
unnamed: R6.1, R8.1, U5.5 (+INB)
unnamed: R20.1, R22.1, U6.5 (+INB)
unnamed: R7.1, U5.3 (+INA)
unnamed: SV1.40, U4.38 (D1_A)
unnamed: SV1.39, U4.39 (D2_A)
unnamed: SV1.36, U4.24 (D0_B)
unnamed: SV1.24, U4.19 (D5_B)
unnamed: SV1.26, U4.20 (D4_B)
unnamed: SV1.37, U4.40 (D3_A)
unnamed: SV1.35, U4.41 (D4_A)
unnamed: SV1.33, U4.42 (D5_A)
unnamed: SV1.28, U4.21 (D3_B)
unnamed: SV1.31, U4.43 (D6_A)
unnamed: SV1.27, U4.44 (D7_A)
unnamed: SV1.32, U4.22 (D2_B)
unnamed: SV1.22, U4.18 (D6_B)
unnamed: SV1.20, U4.17 (D7_B(MSB))
unnamed: SV1.34, U4.23 (D1_B)
unnamed: IC5.9 (C), SV2.19
unnamed: IC5.10 (B), SV2.17
unnamed: IC13.9 (C), SV1.17
unnamed: IC13.10 (B), SV1.15
unnamed: IC13.11 (A), SV1.13
unnamed: IC6.9 (C), SV1.25
unnamed: IC6.10 (B), SV1.23
unnamed: IC6.11 (A), SV1.21
unnamed: IC5.3 (X), R49.1, U5.6 (-INB)
unnamed: R31.1, R32.1, U6.12 (+INC)
unnamed: R33.2, R37.2, R38.2, R39.2, R40.2, R41.2, R42.2, R43.2, R44.2, U7.2 (-INA)
unnamed: C5.2, U2.2 (-INA), U3.1 (IOUT1)
unnamed: R45.1, R46.1, U7.12 (+INC)
unnamed: R5.1, R18.2, U5.1 (OUTA)
unnamed: R35.1, U7.3 (+INA)
unnamed: R21.1, U6.3 (+INA)
unnamed: R47.1, U3.20 (RFB)
unnamed: IC5.11 (A), SV2.15
unnamed: C23.1, SV2.16, U3.16 (CS)
unnamed: R55.2, R56.1, U7.11 (-INC)
unnamed: R51.2, R53.1, U5.11 (-INC)
unnamed: R55.1, R57.2, U7.7 (OUTB)
unnamed: R17.1, R31.2, U6.1 (OUTA)
unnamed: R50.2, R52.1, U6.7 (OUTB)
unnamed: IC6.3 (X), R50.1, U6.6 (-INB)
unnamed: R1.2, R58.1, U2.16 (OUTD)
S1: JP2.2, U4.8 (S1)
S2: JP3.2, U4.9 (S2)
VCC: C1.1, C2.1, C10.1, C11.1, U1.13 (VD3), U1.30 (VD1), U1.31 (VD4), U1.48 (VD2), U4.13 (VD3), U4.30 (VD1), U4.31 (VD4), U4.48 (VD2), X2.6
VDD: C3.1, C4.1, C12.1, C13.1, JP1.1, JP2.1, JP3.1, SV1.30, SV2.30, U1.9 (S2), U1.15 (VDD2), U1.28 (VDD6), U1.33 (VDD4), U1.46 (VDD1), U3.18 (VDD), U4.15 (VDD2), U4.28 (VDD6), U4.33 (VDD4), U4.46 (VDD1)
VEE: IC5.7 (VEE), IC6.7 (VEE), IC13.7 (VEE)
VREF/INA: R19.2, R32.2, R46.2

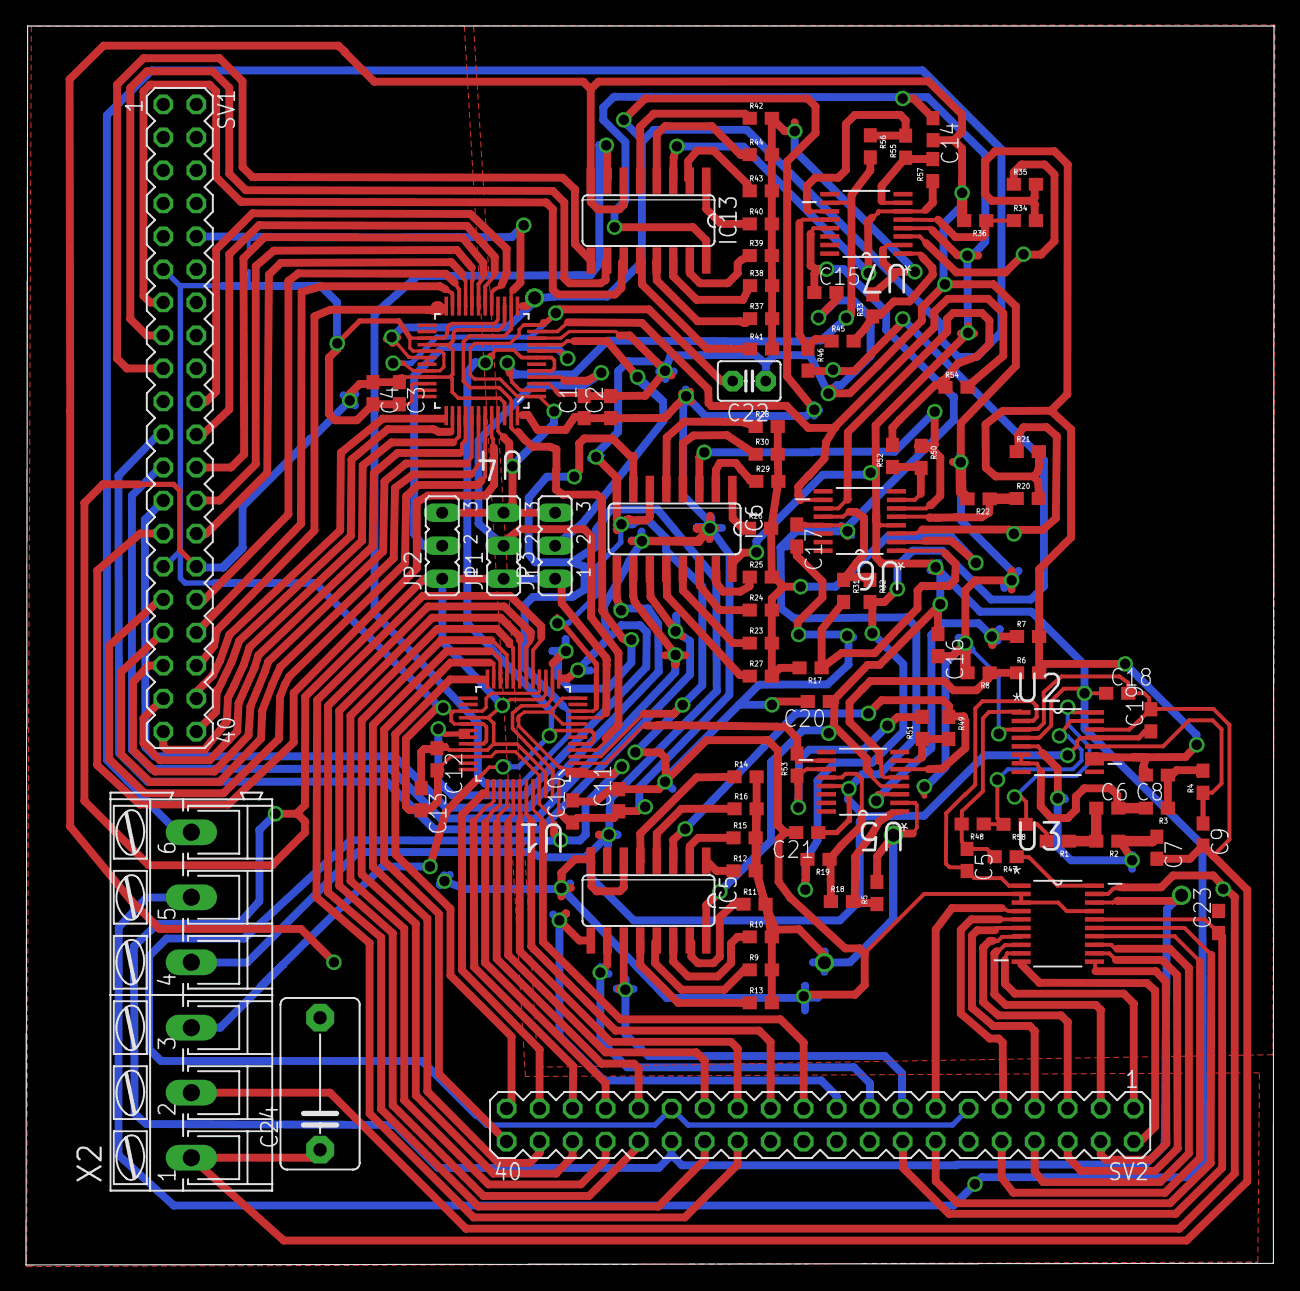
[picture p38: board adc.brd from above]

Board: 2 copper layers, 96.0 x 95.3 mm, 99 parts (1 on the bottom side), 130 nets.
