ronnykg/Iontoforese/ECG_V3.brd

## EAGLE design ECG_V3.brd (2015-06-15)

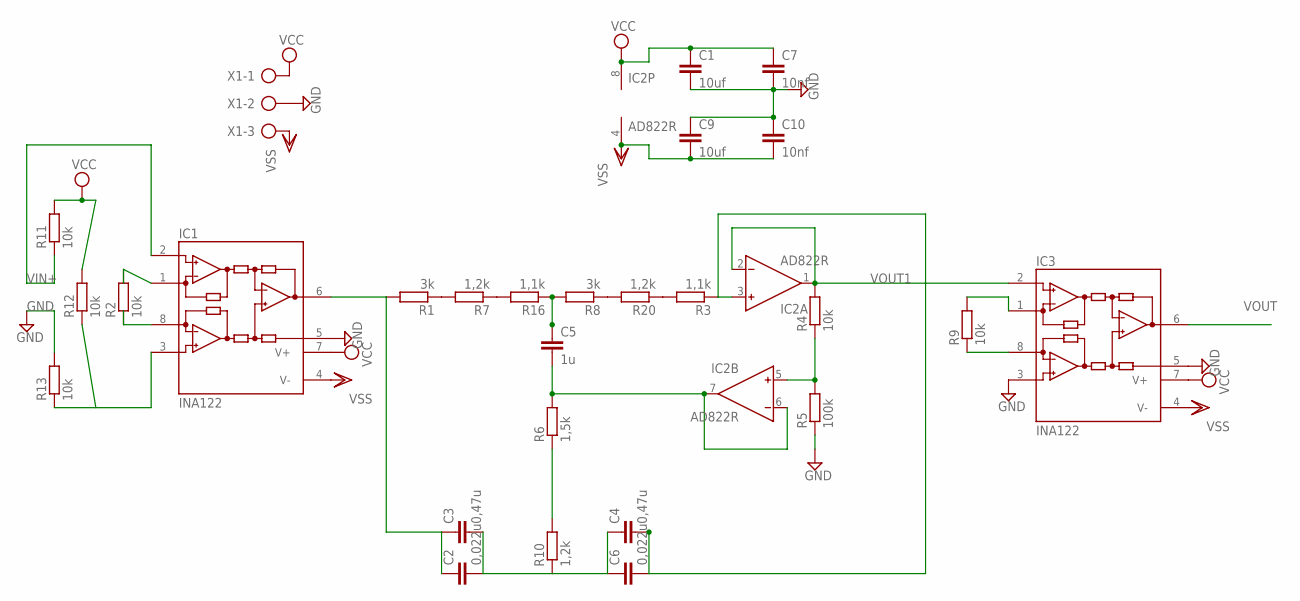
[picture p39: schematic ECG_V3.sch]

Parts:
C1, C9: 10uf; C0603
C2, C6: 0,022u; C0603
C3, C4: 0,47u; C0603
C5: 1u; C0603
C7, C10: 10nf; C0603
IC1, IC3: INA122; SO08
IC2: AD822R; SO8
R1, R8: 3k; R0603
R2, R4, R9, R11, R12, R13: 10k; R0603
R3, R16: 1,1k; R0603
R5: 100k; R0603
R6: 1,5k; R0603
R7, R10, R20: 1,2k; R0603
X1: AK300/3

Connections:
GND: C1.2, C7.2, C9.1, C10.1, IC1.5 (REF), IC3.3 (+IN), IC3.5 (REF), R5.1, R13.2, X1.2
unnamed: IC3.1 (RG), R9.2
unnamed: IC3.8 (RG), R9.1
unnamed: IC1.1 (RG), R2.2
unnamed: IC1.8 (RG), R2.1
unnamed: R1.1, R7.2
unnamed: R7.1, R16.2
unnamed: R3.2, R20.1
unnamed: IC2.5 (IN+), R4.1, R5.2
unnamed: R8.1, R20.2
unnamed: C5.2, IC2.6 (IN-), IC2.7 (OUT), R6.2
unnamed: C5.1, R8.2, R16.1
unnamed: IC1.3 (+IN), R12.1, R13.1
unnamed: R6.1, R10.2
unnamed: C2.2, C3.2, C4.1, C6.1, R10.1
unnamed: C2.1, C3.1, IC1.6 (OUT), R1.2
unnamed: C4.2, C6.2, IC2.3 (IN+), R3.1
VCC: C1.1, C7.1, IC1.7 (V+), IC2.8 (V+), IC3.7 (V+), R11.2, R12.2, X1.1
VIN+: IC1.2 (-IN), R11.1
VOUT: IC3.6 (OUT)
VOUT1: IC2.1 (OUT), IC2.2 (IN-), IC3.2 (-IN), R4.2
VSS: C9.2, C10.2, IC1.4 (V-), IC2.4 (V-), IC3.4 (V-), X1.3

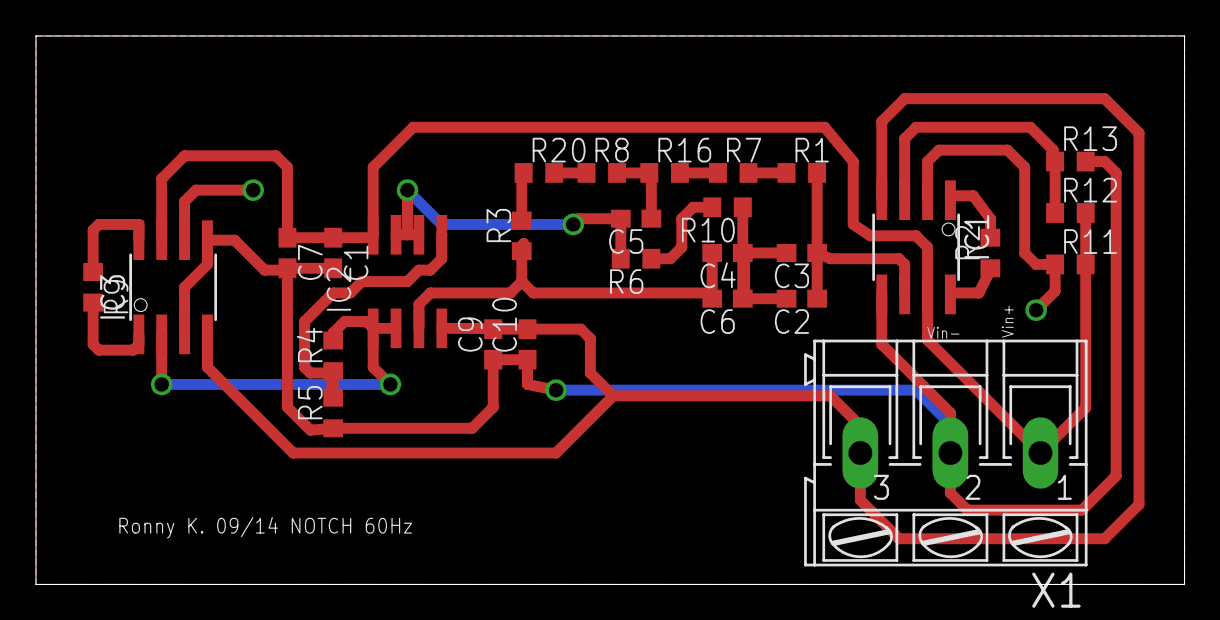
[picture p40: board ECG_V3.brd from above]

Board: 2 copper layers, 63.8 x 30.5 mm, 28 parts (0 on the bottom side), 21 nets.
