ronnykg/Iontoforese/VHDL/my_library.vhd

LIBRARY IEEE;
USE  IEEE.STD_LOGIC_1164.all;
USE  IEEE.STD_LOGIC_ARITH.all;
USE  IEEE.STD_LOGIC_UNSIGNED.all;
use work.types.all;
--Package Types is
--Subtype Segment is std_logic_vector(11 downto 0);
--type memoryDAC is array (INTEGER range <>) of Segment;
--end types;


entity my_library is
port(
                 DAC_SIGNAL: OUT memoryDAC(0 to 4095); --:= ((others=> (others=>'0')));
                 RESET : IN STD_LOGIC
	 );
end my_library;
architecture a of my_library is

begin


DAC_SIGNAL(0) <= conv_std_logic_vector(4095,12) WHEN RESET = '1' ELSE (others=>'0');
DAC_SIGNAL(1) <= conv_std_logic_vector(3945,12) WHEN RESET = '1' ELSE (others=>'0');
DAC_SIGNAL(2) <= conv_std_logic_vector(3538,12) WHEN RESET = '1' ELSE (others=>'0');
DAC_SIGNAL(3) <= conv_std_logic_vector(2993,12) WHEN RESET = '1' ELSE (others=>'0');
DAC_SIGNAL(4) <= conv_std_logic_vector(2460,12) WHEN RESET = '1' ELSE (others=>'0');
DAC_SIGNAL(5) <= conv_std_logic_vector(2070,12) WHEN RESET = '1' ELSE (others=>'0');
DAC_SIGNAL(6) <= conv_std_logic_vector(1898,12) WHEN RESET = '1' ELSE (others=>'0');
DAC_SIGNAL(7) <= conv_std_logic_vector(1936,12) WHEN RESET = '1' ELSE (others=>'0');
DAC_SIGNAL(8) <= conv_std_logic_vector(2114,12) WHEN RESET = '1' ELSE (others=>'0');
DAC_SIGNAL(9) <= conv_std_logic_vector(2326,12) WHEN RESET = '1' ELSE (others=>'0');
DAC_SIGNAL(10) <= conv_std_logic_vector(2476,12) WHEN RESET = '1' ELSE (others=>'0');
DAC_SIGNAL(11) <= conv_std_logic_vector(2510,12) WHEN RESET = '1' ELSE (others=>'0');
DAC_SIGNAL(12) <= conv_std_logic_vector(2431,12) WHEN RESET = '1' ELSE (others=>'0');
DAC_SIGNAL(13) <= conv_std_logic_vector(2290,12) WHEN RESET = '1' ELSE (others=>'0');
DAC_SIGNAL(14) <= conv_std_logic_vector(2157,12) WHEN RESET = '1' ELSE (others=>'0');
DAC_SIGNAL(15) <= conv_std_logic_vector(2089,12) WHEN RESET = '1' ELSE (others=>'0');
DAC_SIGNAL(16) <= conv_std_logic_vector(2107,12) WHEN RESET = '1' ELSE (others=>'0');
DAC_SIGNAL(17) <= conv_std_logic_vector(2193,12) WHEN RESET = '1' ELSE (others=>'0');
DAC_SIGNAL(18) <= conv_std_logic_vector(2297,12) WHEN RESET = '1' ELSE (others=>'0');
DAC_SIGNAL(19) <= conv_std_logic_vector(2369,12) WHEN RESET = '1' ELSE (others=>'0');
DAC_SIGNAL(20) <= conv_std_logic_vector(2375,12) WHEN RESET = '1' ELSE (others=>'0');
DAC_SIGNAL(21) <= conv_std_logic_vector(2315,12) WHEN RESET = '1' ELSE (others=>'0');
DAC_SIGNAL(22) <= conv_std_logic_vector(2221,12) WHEN RESET = '1' ELSE (others=>'0');
DAC_SIGNAL(23) <= conv_std_logic_vector(2136,12) WHEN RESET = '1' ELSE (others=>'0');
DAC_SIGNAL(24) <= conv_std_logic_vector(2097,12) WHEN RESET = '1' ELSE (others=>'0');
DAC_SIGNAL(25) <= conv_std_logic_vector(2117,12) WHEN RESET = '1' ELSE (others=>'0');
DAC_SIGNAL(26) <= conv_std_logic_vector(2181,12) WHEN RESET = '1' ELSE (others=>'0');
DAC_SIGNAL(27) <= conv_std_logic_vector(2253,12) WHEN RESET = '1' ELSE (others=>'0');
DAC_SIGNAL(28) <= conv_std_logic_vector(2296,12) WHEN RESET = '1' ELSE (others=>'0');
DAC_SIGNAL(29) <= conv_std_logic_vector(2288,12) WHEN RESET = '1' ELSE (others=>'0');
DAC_SIGNAL(30) <= conv_std_logic_vector(2231,12) WHEN RESET = '1' ELSE (others=>'0');
DAC_SIGNAL(31) <= conv_std_logic_vector(2152,12) WHEN RESET = '1' ELSE (others=>'0');
DAC_SIGNAL(32) <= conv_std_logic_vector(2086,12) WHEN RESET = '1' ELSE (others=>'0');
DAC_SIGNAL(33) <= conv_std_logic_vector(2061,12) WHEN RESET = '1' ELSE (others=>'0');
DAC_SIGNAL(34) <= conv_std_logic_vector(2085,12) WHEN RESET = '1' ELSE (others=>'0');
DAC_SIGNAL(35) <= conv_std_logic_vector(2142,12) WHEN RESET = '1' ELSE (others=>'0');
DAC_SIGNAL(36) <= conv_std_logic_vector(2200,12) WHEN RESET = '1' ELSE (others=>'0');
DAC_SIGNAL(37) <= conv_std_logic_vector(2228,12) WHEN RESET = '1' ELSE (others=>'0');
DAC_SIGNAL(38) <= conv_std_logic_vector(2209,12) WHEN RESET = '1' ELSE (others=>'0');
DAC_SIGNAL(39) <= conv_std_logic_vector(2150,12) WHEN RESET = '1' ELSE (others=>'0');
DAC_SIGNAL(40) <= conv_std_logic_vector(2076,12) WHEN RESET = '1' ELSE (others=>'0');
DAC_SIGNAL(41) <= conv_std_logic_vector(2020,12) WHEN RESET = '1' ELSE (others=>'0');
DAC_SIGNAL(42) <= conv_std_logic_vector(2006,12) WHEN RESET = '1' ELSE (others=>'0');
DAC_SIGNAL(43) <= conv_std_logic_vector(2037,12) WHEN RESET = '1' ELSE (others=>'0');
DAC_SIGNAL(44) <= conv_std_logic_vector(2094,12) WHEN RESET = '1' ELSE (others=>'0');
DAC_SIGNAL(45) <= conv_std_logic_vector(2147,12) WHEN RESET = '1' ELSE (others=>'0');
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
DAC_SIGNAL(1352) <= conv_std_logic_vector(2376,12) WHEN RESET = '1' ELSE (others=>'0');
DAC_SIGNAL(1353) <= conv_std_logic_vector(2368,12) WHEN RESET = '1' ELSE (others=>'0');
DAC_SIGNAL(1354) <= conv_std_logic_vector(2298,12) WHEN RESET = '1' ELSE (others=>'0');
DAC_SIGNAL(1355) <= conv_std_logic_vector(2202,12) WHEN RESET = '1' ELSE (others=>'0');
DAC_SIGNAL(1356) <= conv_std_logic_vector(2124,12) WHEN RESET = '1' ELSE (others=>'0');
DAC_SIGNAL(1357) <= conv_std_logic_vector(2097,12) WHEN RESET = '1' ELSE (others=>'0');
DAC_SIGNAL(1358) <= conv_std_logic_vector(2128,12) WHEN RESET = '1' ELSE (others=>'0');
DAC_SIGNAL(1359) <= conv_std_logic_vector(2196,12) WHEN RESET = '1' ELSE (others=>'0');
DAC_SIGNAL(1360) <= conv_std_logic_vector(2265,12) WHEN RESET = '1' ELSE (others=>'0');
DAC_SIGNAL(1361) <= conv_std_logic_vector(2299,12) WHEN RESET = '1' ELSE (others=>'0');
DAC_SIGNAL(1362) <= conv_std_logic_vector(2279,12) WHEN RESET = '1' ELSE (others=>'0');
DAC_SIGNAL(1363) <= conv_std_logic_vector(2216,12) WHEN RESET = '1' ELSE (others=>'0');
DAC_SIGNAL(1364) <= conv_std_logic_vector(2136,12) WHEN RESET = '1' ELSE (others=>'0');
DAC_SIGNAL(1365) <= conv_std_logic_vector(2077,12) WHEN RESET = '1' ELSE (others=>'0');
DAC_SIGNAL(1366) <= conv_std_logic_vector(2062,12) WHEN RESET = '1' ELSE (others=>'0');
DAC_SIGNAL(1367) <= conv_std_logic_vector(2095,12) WHEN RESET = '1' ELSE (others=>'0');
DAC_SIGNAL(1368) <= conv_std_logic_vector(2155,12) WHEN RESET = '1' ELSE (others=>'0');
DAC_SIGNAL(1369) <= conv_std_logic_vector(2209,12) WHEN RESET = '1' ELSE (others=>'0');
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
