ronnykg/Iontoforese/VHDL/MY_PACKAGE.vhd

library IEEE;
use IEEE.std_logic_1164.all;
use ieee.numeric_std.all;    -- for UNSIGNED
PACKAGE MY_PACKAGE IS
function  sqrt  ( d : UNSIGNED ) return UNSIGNED;
END PACKAGE;
PACKAGE BODY MY_PACKAGE IS
function  sqrt  ( d : UNSIGNED ) return UNSIGNED IS
variable a : unsigned(31 downto 0):=d;  --original input.
variable q : unsigned(15 downto 0):=(others => '0');  --result.
variable left,right,r : unsigned(17 downto 0):=(others => '0');  --input to adder/sub.r-remainder.
variable i : integer:=0;

begin
for i in 0 to 15 loop
right(0):='1';
right(1):=r(17);
right(17 downto 2):=q;
left(1 downto 0):=a(31 downto 30);
left(17 downto 2):=r(15 downto 0);
a(31 downto 2):=a(29 downto 0);  --shifting by 2 bit.
if ( r(17) = '1') then
r := left + right;
else
r := left - right;
end if;
q(15 downto 1) := q(14 downto 0);
q(0) := not r(17);
end loop; 
return q;
end sqrt;

END PACKAGE BODY;
