ronnykg/Iontoforese/(commit log)

2015-06-15 Repositório 2
    Adicionado quase todos os arquivos, ignorado .bak .wav
    [DE2_Clock.smp_dump.txt, ECG_V3.brd, ECG_V3.sch, NOTCH.xlsx, _vhdl.psm, a.psm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]
2015-07-07 Updade 1V ADC.brd enviada pra digikart
    [NOTCH.xlsx, adc.brd, adc.sch]
2015-11-18 atualização
    FPGA - send ADC
    C# - DFT
    Placa - 2 grounds
    [NOTCH.xlsx, adc.sch]
2016-02-25 Atualização
    [DE2_Clock.smp_dump.txt, _vhdl.psm, a.psm, adc.brd, body.psm, handler.psm]
2016-05-03 atualização de dados
    [NOTCH.xlsx]
2016-08-24 new data
    [NOTCH.xlsx]
